dmitchellspace/bad-habips/README.md

# bad-habips
Repository for the High Altitude Balloon Instrumentation Platform senior design project for the 2017-2018 school year at the Rochester Institute of Technology
