dmitchellspace/bad-habips/PCB/Documentation/MainBoardV2_BOM.xlsx

Sheet: Rev 2
RIT MSD P18104: Bad Habips - High Altitute Balloon Instrumentation Platform Main Board V2 BOM
Ref | Description | Manf Part Number | Manf | Footprint | Purchase Link | Quantity | Price | Sub Total
C1, C2, C4, C5, C6, C7, C10, C11, C26 | 10uF, 25V | GRM21BR61E106MA73L | Murata | 0805(2012 Metric) | Digikey (https://www.digikey.com/product-detail/en/murata-electronics-north-america/GRM21BR61E106MA73L/490-10748-1-ND/5251352) | 9 | 0.21000 | 1.89
C3, C8, C15, C25 | 1uF, 16V | CL21B105KOFNNNG | Samsung | 0805(2012 Metric) | Digikey (https://www.digikey.com/product-detail/en/samsung-electro-mechanics/CL21B105KOFNNNG/1276-6471-1-ND/5958099) | 4 | 0.10000 | 0.40
C9, C24, C33 | 1nF | C0805C102K5RACTU | Kemet | 0805(2012 Metric) | Digikey (https://www.digikey.com/product-detail/en/kemet/C0805C102K5RACTU/399-1147-1-ND/411422) | 3 | 0.10000 | 0.30
C12, C18, C20, C22, C23, C27, C28, C29 | 0.1uF, 16V | ECP-U1C104MA5 | Panasonic | 0805(2012 Metric) | Digikey (https://www.digikey.com/product-detail/en/panasonic-electronic-components/ECP-U1C104MA5/PCF1126CT-ND/285453) | 8 | 0.66000 | 5.28
C13 | 10pF, 50V | CC0805JRNPO9BN100 | Yageo | 0805(2012 Metric) | Digikey (https://www.digikey.com/product-detail/en/yageo/CC0805JRNPO9BN100/311-1099-1-ND/303009) | 1 | 0.10000 | 0.10
C14 | 47uF, 16V | EMK325BJ476MM-P | Taiyo Yuden | 1210 (3225 Metric) | Digikey (https://www.digikey.com/product-detail/en/taiyo-yuden/EMK325BJ476MM-P/587-5436-1-ND/7067112) | 1 | 0.71000 | 0.71
C16 | 1F, 5.5V | KR-5R5C105-R | Eaton | Through-Hole | Digikey (https://www.digikey.com/product-detail/en/eaton/KR-5R5C105-R/283-2810-ND/1556238) | 1 | 2.72000 | 2.72
C17, C32 | 10000pF, 16V | ECH-U1C103JX5 | Panasonic | 0805(2012 Metric) | Digikey (https://www.digikey.com/product-detail/en/panasonic-electronic-components/ECH-U1C103JX5/PCF1196CT-ND/353743) | 2 | 0.46000 | 0.92
C30, C31 | 22pF | C0805C220J5GACTU | Kemet | 0805(2012 Metric) | Digikey (https://www.digikey.com/product-detail/en/kemet/C0805C220J5GACTU/399-1113-1-ND/411388) | 2 | 0.10000 | 0.20
D1, D2, D6 | 18V, 1W Zener | SMAZ18-13-F | Diodes Inc | DO-214AC | Digikey (https://www.digikey.com/product-detail/en/diodes-incorporated/SMAZ18-13-F/SMAZ18-FDICT-ND/816042) | 3 | 0.50000 | 1.50
D3, D4, D11 | 40V, 5A Schottky | CDBA540-HF | Comchip | DO-214AC | Digikey (https://www.digikey.com/product-detail/en/comchip-technology/CDBA540-HF/641-1707-1-ND/5226090) | 3 | 0.49000 | 1.47
D5 | Green LED | VLMG21J2M1-GS08 | Vishay | 2-SMD, J-Lead | Digikey (https://www.digikey.com/product-detail/en/vishay-semiconductor-opto-division/VLMG21J2M1-GS08/VLMG21J2M1-GS08CT-ND/4895911) | 1 | 0.47000 | 0.47
D7, D9 | Green LED | APT2012LZGCK | Kingbright | 0805(2012 Metric) | Digikey (https://www.digikey.com/product-detail/en/kingbright/APT2012LZGCK/754-1939-1-ND/5177469) | 2 | 0.61000 | 1.22
D8, D10 | Blue LED | HSMR-C170 | Broadcom | 0805(2012 Metric) | Digikey (https://www.digikey.com/product-detail/en/broadcom-limited/HSMR-C170/516-1445-1-ND/637769) | 2 | 0.89000 | 1.78
D16, D31, D34 | Red LED | LTST-C171KRKT | Lite-On | 0805(2012 Metric) | Digikey (https://www.digikey.com/product-detail/en/lite-on-inc/LTST-C171KRKT/160-1427-1-ND/386800) | 3 | 0.31000 | 0.93
D19, D20, D21, D22, D23, D24, D25, D26, D27, D28, D29, D30 | TVS Diodes | MMQA5V6T1G | On Semi | SC-74 | Digikey (https://www.digikey.com/product-detail/en/on-semiconductor/MMQA5V6T1G/MMQA5V6T1GOSCT-ND/1139867) | 12 | 0.31800 | 3.82
J1, J2, J3, J6, J7, J11, J12, J16 | 4POS 3MM Micro-Fit 3.0 Horizontal | 0430450400 | Molex | Custom Through-Hole | Digikey (https://www.digikey.com/product-detail/en/molex-llc/0430450400/WM1814-ND/252527) | 8 | 1.35000 | 10.80
Mates for Above | 4POS 3MM Mating Micro-Fit 3.0 | 43025-0400 | Molex | In-Line | Digikey (https://www.digikey.com/product-detail/en/molex-llc/43025-0400/WM1784-ND/252497) | 8 | 0.40000 | 3.20
J4, J9 | 6POS 3MM Micro-Fit 3.0 Horizontal | 0430450600 | Molex | Custom Through-Hole | Digikey (https://www.digikey.com/product-detail/en/molex-llc/0430450600/WM1815-ND/252528) | 2 | 1.71000 | 3.42
Mates for Above | 6POS 3MM Mating Micro-Fit 3.0 | 43025-0600 | Molex | In-Line | Digikey (https://www.digikey.com/product-detail/en/molex-llc/43025-0600/WM1785-ND/252498) | 2 | 0.43000 | 0.86
J5 | 8POS 3MM Micro-Fit 3.0 Horizontal | 0430450800 | Molex | Custom Through-Hole | Digikey (https://www.digikey.com/product-detail/en/molex-llc/0430450800/WM1816-ND/252529) | 1 | 2.09000 | 2.09
Mates for Above | 8POS 3MM Mating Micro-Fit 3.0 | 43025-0800 | Molex | In-Line | Digikey (https://www.digikey.com/product-detail/en/molex-llc/43025-0800/WM1786-ND/252499) | 1 | 0.49000 | 0.49
J8, J10, J14, J15, J17 | 2POS Right Angle Vertical | 1586041-2 | TE Connect. | Custom Through-Hole | Digikey (https://www.digikey.com/product-detail/en/1586041-2/A30614-ND/701619) | 5 | 0.70000 | 3.50
Mates for Above | CONN RCPT HOUSING 2POS 4.2MM | 1586019-2 | TE Connect. | In-Line | Digikey (https://www.digikey.com/product-detail/en/te-connectivity-amp-connectors/1586019-2/A107333-ND/1131454) | 5 | 0.21000 | 1.05
J13 | 4POS JST-PH Vertical 2.54mm | 4330589508 | WGCD | 2.54MM Header | Amazon (https://smile.amazon.com/gp/product/B071XW2JND/ref=oh_aui_detailpage_o05_s00?ie=UTF8&psc=1) | 1 | 9.79000 | 9.79
J18 | 7POS JST-PH Vertical 2.54mm | 4330589508 | WGCD | 2.54MM Header
Mates for Above | Kit included mates and pins | 4330589508 | WGCD | In-Line
J21 | 2POS 3MM Micro-Fit 3.0 Horizontal | 0436500200 | Molex | Custom Through-Hole | Digikey (https://www.digikey.com/product-detail/en/molex-llc/0436500200/WM1860-ND/268989) | 1 | 0.91000 | 0.91
Mates for Above | 2POS 3MM Mating Micro-Fit 3.0 | 43645-0200 | Molex | In-Line | Digikey (https://www.digikey.com/product-detail/en/molex-llc/43645-0200/WM1845-ND/268974) | 1 | 0.31000 | 0.31
TE Pins | Mating Pins for TE Connector | 1586315-1 | TE Connect. | In-Line | Digikey (https://www.digikey.com/product-detail/en/te-connectivity-amp-connectors/1586315-1/A30642-ND/701647) | 50 | 0.04520 | 2.26
Molex Pins | Mating pins for Molex Connectors | 43030-0001 | Molex | In-Line | Digikey (https://www.digikey.com/product-detail/en/molex-llc/43030-0001/WM1837CT-ND/467810) | 100 | 0.08390 | 8.39
J19 | Headers - 1x2 | B01MQ48T2V | OCRTech | 2.54MM Header | Amazon (https://smile.amazon.com/OCR-Breakaway-Connector-Assortment-Arduino/dp/B01MQ48T2V) | 1 | 6.99000 | 6.99
 |  |  |  |  |  | 0 |  | 0.00
L1 | 6.8uH, 3.7A | NRS8040T6R8NJGJ | Taiyo Yuden | Nonstandard SMT | Digikey (https://www.digikey.com/product-detail/en/taiyo-yuden/NRS8040T6R8NJGJ/587-2979-1-ND/2666084) | 1 | 0.51000 | 0.51
 |  |  |  |  |  | 0 |  | 0.00
Q1 | N-CH, 30V, 20A | NTD20N03L27T4G | On Semi | DPAK | Digikey (https://www.digikey.com/product-detail/en/on-semiconductor/NTD20N03L27T4G/NTD20N03L27T4GOSCT-ND/921548) | 1 | 1.08000 | 1.08
Q2, Q4, Q17 | P-CH, 30V, 3.8A | DMP3099L-7 | Diodes Inc. | SOT-23-3 | Digikey (https://www.digikey.com/product-detail/en/diodes-incorporated/DMP3099L-7/DMP3099L-7DICT-ND/5218217) | 3 | 0.42 | 1.26
Q3, Q5, Q6, Q7, Q8, Q9, Q12, Q14, Q15, Q18 | N-CH, 30V, 500mA | NTR4003NT3G | ON Semi | SOT-23-3 | Digikey (https://www.digikey.com/product-detail/en/on-semiconductor/NTR4003NT3G/NTR4003NT3GOSCT-ND/1967271) | 10 | 0.29 | 2.92
 |  |  |  |  |  | 0 |  | 0.00
R1, R4, R6, R37, R38, R40, R41, R43, R44, R45, R46, R51, R52, R53, R61, R63, R64 | 10kΩ,, 0.4W | ESR10EZPJ103 | Rohm | 0805 (2012 Metric) | Digikey (https://www.digikey.com/product-detail/en/rohm-semiconductor/ESR10EZPJ103/RHM10KKCT-ND/1762952) | 17 | 0.09 | 1.48
R2 | 2Ω, 1%, 20W | PF1262-2RF1 | Riedon | TO126 | Digikey (https://www.digikey.com/scripts/DkSearch/dksus.dll?Detail&itemSeq=251921007&uq=636546449291790512) | 1 | 3.04000 | 3.04
R3, R35, R47, R48, R49, R59 | 10Ω, 5%, 2/5W | ESR10EZPJ100 | Rohm | 0805 (2012 Metric) | Digikey (https://www.digikey.com/product-detail/en/rohm-semiconductor/ESR10EZPJ100/RHM10KCT-ND/1762949) | 6 | 0.10 | 0.60
R5, R8, R9 | 10mΩ, 1%, 1W | WSLP0805R0100FEA18 | Vishay Dale | 0805 (2012 Metric) | Digikey (https://www.digikey.com/products/en/resistors/chip-resistor-surface-mount/52?k=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) | 3 | 1.08000 | 3.24
R7 | 100kΩ, 5%, 1/8W | RC0805JR-07100KL | Yageo | 0805 (2012 Metric) | Digikey (https://www.digikey.com/product-detail/en/yageo/RC0805JR-07100KL/311-100KARCT-ND/731186) | 1 | 0.10000 | 0.10
R10 | 40.2kΩ, 1%, 1/8W | RC0805FR-0740K2L | Yageo | 0805 (2012 Metric) | Digikey (https://www.digikey.com/product-detail/en/yageo/RC0805FR-0740K2L/311-40.2KCRCT-ND/730888) | 1 | 0.10000 | 0.10
R11 | 3.57kΩ, 1%, 1/8W | RC0805FR-073K57L | Yageo | 0805 (2012 Metric) | Digikey (https://www.digikey.com/product-detail/en/yageo/RC0805FR-073K57L/311-3.57KCRCT-ND/730772) | 1 | 0.10000 | 0.10
R12 | 10.5kΩ, 1%, 1/8W | RC0805FR-0710K5L | Yageo | 0805 (2012 Metric) | Digikey (https://www.digikey.com/product-detail/en/yageo/RC0805FR-0710K5L/311-10.5KCRCT-ND/730487) | 1 | 0.10000 | 0.10
R13 | 7.5kΩ, 1%, 1/8W | RC0805FR-077K5L | Yageo | 0805 (2012 Metric) | Digikey (https://www.digikey.com/product-detail/en/yageo/RC0805FR-077K5L/311-7.50KCRCT-ND/731063) | 1 | 0.10000 | 0.10
R14 | 11.8kΩ, 1%, 1/8W | RC0805FR-0711K8L | Yageo | 0805 (2012 Metric) | Digikey (https://www.digikey.com/product-detail/en/yageo/RC0805FR-0711K8L/311-11.8KCRCT-ND/730505) | 1 | 0.10000 | 0.10
R15 | 261kΩ, 1%, 1/8W | RC0805FR-07261KL | Yageo | 0805 (2012 Metric) | Digikey (https://www.digikey.com/product-detail/en/yageo/RC0805FR-07261KL/311-261KCRCT-ND/730723) | 1 | 0.10000 | 0.10
R16 | 35.7kΩ, 1%, 1/8W | RC0805FR-0735K7L | Yageo | 0805 (2012 Metric) | Digikey (https://www.digikey.com/product-detail/en/yageo/RC0805FR-0735K7L/311-35.7KCRCT-ND/730826) | 1 | 0.10000 | 0.10
R17 | 681kΩ, 1%, 1/8W | RC0805FR-07681KL | Yageo | 0805 (2012 Metric) | Digikey (https://www.digikey.com/product-detail/en/yageo/RC0805FR-07681KL/311-681KCRCT-ND/731051) | 1 | 0.10000 | 0.10
R18, R21, R24 | 102kΩ, 1%, 1/8W | RC0805FR-07102KL | Yageo | 0805 (2012 Metric) | Digikey (https://www.digikey.com/product-detail/en/yageo/RC0805FR-07102KL/311-102KCRCT-ND/730493) | 3 | 0.10000 | 0.30
R19 | 107kΩ, 1%, 1/8W | RC0805FR-07107KL | Yageo | 0805 (2012 Metric) | Digikey (https://www.digikey.com/product-detail/en/yageo/RC0805FR-07107KL/311-107KCRCT-ND/730497) | 1 | 0.10000 | 0.10
R20, R23 | 41.2kΩ, 1%, 1/8W | RC0805FR-0741K2L | Yageo | 0805 (2012 Metric) | Digikey (https://www.digikey.com/product-detail/en/yageo/RC0805FR-0741K2L/311-41.2KCRCT-ND/730892) | 2 | 0.10000 | 0.20
R22, R25, R29, R32 | 10.2kΩ, 1%, 1/8W | RC0805FR-0710K2L | Yageo | 0805 (2012 Metric) | Digikey (https://www.digikey.com/product-detail/en/yageo/RC0805FR-0710K2L/311-10.2KCRCT-ND/730485) | 4 | 0.10000 | 0.40
R26 | 75kΩ, 1%, 1/8W | RC0805FR-0775KL | Yageo | 0805 (2012 Metric) | Digikey (https://www.digikey.com/product-detail/en/yageo/RC0805FR-0775KL/311-75.0KCRCT-ND/731080) | 1 | 0.10000 | 0.10
R27 | 13.7kΩ, 1%, 1/8W | RC0805FR-0713K7L | Yageo | 0805 (2012 Metric) | Digikey (https://www.digikey.com/product-detail/en/yageo/RC0805FR-0713K7L/311-13.7KCRCT-ND/730535) | 1 | 0.10000 | 0.10
R28 | 18.7kΩ, 1%, 1/8W | RC0805FR-0718K7L | Yageo | 0805 (2012 Metric) | Digikey (https://www.digikey.com/product-detail/en/yageo/RC0805FR-0718K7L/311-18.7KCRCT-ND/730595) | 1 | 0.10000 | 0.10
R30, R33 | 43.2kΩ, 1%, 1/8W | RC0805FR-0743K2L | Yageo | 0805 (2012 Metric) | Digikey (https://www.digikey.com/product-detail/en/yageo/RC0805FR-0743K2L/311-43.2KCRCT-ND/730902) | 2 | 0.10000 | 0.20
R31, R34 | 15kΩ, 1%, 1/8W | RC0805FR-0715KL | Yageo | 0805 (2012 Metric) | Digikey (https://www.digikey.com/product-detail/en/yageo/RC0805FR-0715KL/311-15.0KCRCT-ND/730555) | 2 | 0.10000 | 0.20
R36, R54 | 1.2kΩ, 5%, 1/8W | RC0805FR-071K2L | Yageo | 0805 (2012 Metric) | Digikey (https://www.digikey.com/product-detail/en/yageo/RC0805FR-071K2L/311-1.20KCRCT-ND/730413) | 2 | 0.10000 | 0.20
R39, R55 | 100Ω, 5%, 1/8W | RC0805JR-07100RL | Yageo | 0805 (2012 Metric) | Digikey (https://www.digikey.com/product-detail/en/yageo/RC0805JR-07100RL/311-100ARCT-ND/731185) | 2 | 0.10000 | 0.20
R42, R57 | 150Ω, 5%, 1/8W | RC0805JR-07150RL | Yageo | 0805 (2012 Metric) | Digikey (https://www.digikey.com/product-detail/en/yageo/RC0805JR-07150RL/311-150ARCT-ND/731202) | 2 | 0.10000 | 0.20
R50 | 0, 1/8W | RC0805JR-070RL | Yageo | 0805 (2012 Metric) | Digikey (https://www.digikey.com/product-detail/en/yageo/RC0805JR-070RL/311-0.0ARCT-ND/731163) | 1 | 0.10000 | 0.10
R60 | 330Ω, 5%, 1/8W | RC0805JR-07330RL | Yageo | 0805 (2012 Metric) | Digikey (https://www.digikey.com/product-detail/en/yageo/RC0805JR-07330RL/311-330ARCT-ND/731258) | 1 | 0.10000 | 0.10
R62 | 910Ω, 5%, 1/8W | RC0805JR-07910RL | Yageo | 0805 (2012 Metric) | Digikey (https://www.digikey.com/product-detail/en/yageo/RC0805JR-07910RL/311-910ARCT-ND/731329) | 1 | 0.10000 | 0.10
 |  |  |  |  |  | 0 |  | 0.00
SW1, SW3 | TACTILE SPST-NO 0.05A 12V | PTS645SM43SMTR92 LFS | C & K | Nonstandard SMT | Digikey (https://www.digikey.com/product-detail/en/c-k/PTS645SM43SMTR92%20LFS/CKN9112CT-ND/1146934) | 2 | 0.16000 | 0.32
SW2, SW4 | SWITCH SLIDE DPDT 5A 120V | 500SDP1S1M2QEA | E-Switch | Throuh Hole | Digikey (https://www.digikey.com/scripts/DkSearch/dksus.dll?Detail&itemSeq=251921006&uq=636546479865490512) | 2 | 3.55000 | 7.10
 |  |  |  |  |  | 0 |  | 0.00
U1 | Dual Power Monitor | LTC2992IDE#PBF | Linear Tech | 16-DFN (4x3) | Digikey (https://www.digikey.com/product-detail/en/linear-technology-analog-devices/LTC2992IDE-PBF/LTC2992IDE-PBF-ND/7807747) | 1 | 9.64000 | 9.64
U2, U3 | Adjustable 1.5A LDO | AZ2117H-ADJTRG1 | Diodes Inc. | SOT-223 | Digikey (https://www.digikey.com/product-detail/en/AZ2117H-ADJTRG1/AZ2117H-ADJTRG1DICT-ND/7670077) | 2 | 0.40000 | 0.80
U4 | Switching Regulator | LT8609EMSE#PBF | Linear Tech | 10-TFSOP, 10-MSOP | Digikey (https://www.digikey.com/products/en?keywords=LT8609EMSE%23PBF) | 1 | 5.46 | 5.46
U5 | Teensy 3.6 | TEENSY36 | PJRC | DIP | PJRC (https://www.pjrc.com/store/teensy36.html) | 1 | 29.95000 | 29.95
U6 | IMU + Magnetometer | LSM9DS1TR | ST Micro | Nonstandard SMT | Digikey (https://www.digikey.com/product-detail/en/stmicroelectronics/LSM9DS1TR/497-14946-1-ND/4988079) | 1 | 6.33000 | 6.33
U7 | Temp/Pressure/Humidity Sensor | BME280 | Bosch | 8-LGA | Digikey (https://www.digikey.com/product-detail/en/bosch-sensortec/BME280/828-1063-1-ND/6136314) | 1 | 7.56 | 7.56
U8 | MCU 16BIT 256KB FRAM | MSP430FR5994IPNR | T.I. | 80LQFP | Digikey (https://www.digikey.com/product-detail/en/texas-instruments/MSP430FR5994IPNR/296-45561-1-ND/6826916) | 1 | 7.89000 | 7.89
U10, U11, U12 | TVS DIODE 2.5VWM 5VC | AOZ8318DI | A & O Semi | 10DFN | Digikey (https://www.digikey.com/product-detail/en/alpha-omega-semiconductor-inc/AOZ8318DI/785-1703-1-ND/5014273) | 3 | 0.91000 | 2.73
 |  |  |  |  |  | 0 |  | 0.00
Y1 | 32.7680kHZ Crystal | AB38T-32.768KHZ | Abracon | Through Hole | Digikey (https://www.digikey.com/product-detail/en/abracon-llc/AB38T-32.768KHZ/535-9034-ND/675229) | 1 | 0.17 | 0.17
Y2 | 24.000MHZ CMOS | ASEMB-24.000MHZ-LC-T | Abracon | 4-SMD | Digikey (https://www.digikey.com/product-detail/en/abracon-llc/ASEMB-24.000MHZ-LC-T/535-11748-1-ND/2809997) | 1 | 1.14000 | 1.14
 |  |  |  |  |  | 0 |  | 0.00
 |  |  |  |  |  | Total Cost |  | 174.48

Sheet: Reference
RIT MSD P18104: Bad Habips - High Altitute Balloon Instrumentation Platform Main Board V2 BOM
Ref | Description | Manf Part Number | Manf | Footprint | Datasheet | Purchase Link | Quantity | Price | Sub Total
C1, C2 | 8pF, 50V | CL21C080CBANNNC | Samsung | 0805(2012 Metric) |  | Digikey (https://www.digikey.com/product-detail/en/samsung-electro-mechanics-america-inc/CL21C080CBANNNC/1276-2556-1-ND/3890642) | 2 | 0.10 | 0.20
C3, C6, C12, C18, C19, C22, C23 | 0.1uF, 16V | ECP-U1C104MA5 | Panasonic | 0805(2012 Metric) |  | Digikey (https://www.digikey.com/product-detail/en/panasonic-electronic-components/ECP-U1C104MA5/PCF1126CT-ND/285453) | 7 | 0.66 | 4.62
C4 | 1F, 5.5V | KR-5R5C105-R | Eaton | Through-Hole |  | Digikey (https://www.digikey.com/product-detail/en/eaton/KR-5R5C105-R/283-2810-ND/1556238) | 1 | 2.72 | 2.72
C5, C7, C10 | 10uF, 25V | GRM21BR61E106MA73L | Murata | 0805(2012 Metric) |  | Digikey (https://www.digikey.com/product-detail/en/murata-electronics-north-america/GRM21BR61E106MA73L/490-10748-1-ND/5251352) | 3 | 0.21 | 0.63
C8, C13 | 1uF, 16V | CL21B105KOFNNNG | Samsung | 0805(2012 Metric) |  | Digikey (https://www.digikey.com/product-detail/en/samsung-electro-mechanics/CL21B105KOFNNNG/1276-6471-1-ND/5958099) | 2 | 0.10 | 0.20
C9 | 10nF, 50V | CC0805KRX7R9BB103 | Yageo | 0805(2012 Metric) |  | Digikey (https://www.digikey.com/product-detail/en/yageo/CC0805KRX7R9BB103/311-1136-1-ND/303046) | 1 | 0.10 | 0.10
C11 | 10000pF, 16V | ECH-U1C103JX5 | Panasonic | 0805(2012 Metric) |  | Digikey (https://www.digikey.com/product-detail/en/panasonic-electronic-components/ECH-U1C103JX5/PCF1196CT-ND/353743) | 1 | 0.46 | 0.46
C14 | 10pF, 50V | CC0805JRNPO9BN100 | Yageo | 0805(2012 Metric) |  | Digikey (https://www.digikey.com/product-detail/en/yageo/CC0805JRNPO9BN100/311-1099-1-ND/303009) | 1 | 0.10 | 0.10
C15, C21 | 47uF, 25V | TMK325ABJ476MM-P | Taiyo Yuden | 1210 (3225 Metric) |  | Digikey (https://www.digikey.com/product-detail/en/taiyo-yuden/TMK325ABJ476MM-P/587-5479-1-ND/7067155) | 2 | 1.24 | 2.48
C16 | 0.1uF, 100V | CL21B104KCFNNNE | Samsung | 0805(2012 Metric) |  | Digikey (https://www.digikey.com/product-detail/en/samsung-electro-mechanics/CL21B104KCFNNNE/1276-6840-1-ND/5961699) | 1 | 0.10 | 0.10
C17 | 47nF, 50V | CL21B473KBCWPNC | Samsung | 0805(2012 Metric) |  | Digikey (https://www.digikey.com/product-detail/en/samsung-electro-mechanics/CL21B473KBCWPNC/1276-6567-1-ND/5961426) | 1 | 0.10 | 0.10
C20 | 6.8uF, 10V | C2012X7R1A685K125AC | TDK | 0805(2012 Metric) |  | Digikey (https://www.digikey.com/product-detail/en/tdk-corporation/C2012X7R1A685K125AC/445-14529-1-ND/3956195) | 1 | 0.46 | 0.46
D1, D5, D10 | 15V TVS | MMBZ15VALT1 | On Semi | SOT-23-3 (TO-236) |  | Digikey (https://www.digikey.com/product-detail/en/on-semiconductor/MMBZ15VALT1G/MMBZ15VALT1GOSCT-ND/964552) | 3 | 0.23 | 0.69
D2 | 33V TVS | MMBZ33VALT1G | On Semi | SOT-23-3 (TO-236) |  | Digikey (https://www.digikey.com/product-detail/en/on-semiconductor/MMBZ33VALT1G/MMBZ33VALT1GOSCT-ND/1139843) | 1 | 0.21 | 0.21
D3 | Gen Purp, 200mA | BAS21LT1G | On Semi | SOT-23-3 (TO-236) |  | Digikey (https://www.digikey.com/product-detail/en/on-semiconductor/BAS21LT1G/BAS21LT1GOSCT-ND/917803) | 1 | 0.11 | 0.11
D4 | Green | VLMG21J2M1-GS08 | Vishay | 2-SMD, J-Lead |  | Digikey (https://www.digikey.com/product-detail/en/vishay-semiconductor-opto-division/VLMG21J2M1-GS08/VLMG21J2M1-GS08CT-ND/4895911) | 1 | 0.47 | 0.47
D6 | Orange | VLMO20J2M1-GS08 | Vishay | 2-SMD, J-Lead |  | Digikey (https://www.digikey.com/product-detail/en/vishay-semiconductor-opto-division/VLMO20J2M1-GS08/VLMO20J2M1-GS08CT-ND/4895914) | 1 | 0.43 | 0.43
D7, D15, D16 | Sschottky 40V 2A | CDBA240LL-HF | Comchip | DO-214AC, SMA |  | Digikey (https://www.digikey.com/product-detail/en/comchip-technology/CDBA240LL-HF/641-1698-1-ND/5226081) | 3 | 0.55 | 1.65
D8, D11, D13, D14, D21 | 5.1V, 500mW Zener | MMSZ5231B-7-F | Diodes Inc. | SOD-123 |  | Digikey (https://www.digikey.com/product-detail/en/diodes-incorporated/MMSZ5231B-7-F/MMSZ5231B-FDICT-ND/755506) | 5 | 0.16 | 0.80
D9 | Amber | VLMK233U1AA-GS08 | Vishay | 2-SMD, J-Lead |  | Digikey (https://www.digikey.com/product-detail/en/vishay-semiconductor-opto-division/VLMK233U1AA-GS08/VLMK233U1AA-GS08CT-ND/3025480) | 1 | 0.55 | 0.55
D12 | Blue | CLM3A-BKW-CTBVA463 | Cree | 2-SMD, J-Lead |  | Digikey (https://www.digikey.com/product-detail/en/cree-inc/CLM3A-BKW-CTBVA463/CLM3A-BKW-CTBVA463CT-ND/6561769) | 1 | 0.16 | 0.16
D17, D18 | 25V TVS Zener | PGB1010603MR | Littlefuse | 0603 (1608 Metric) |  | Digikey (https://www.digikey.com/product-detail/en/littelfuse-inc/PGB1010603MR/F2594CT-ND/813072) | 2 | 0.65 | 1.30
D19 | 93.6V TVS Zener, 400W Peak | SMAJ58CA | Littlefuse | DO-214AC |  | Digikey (https://www.digikey.com/product-detail/en/littelfuse-inc/SMAJ58CA/SMAJ58CALFCT-ND/762523) | 1 | 0.45 | 0.45
D20 | 17.8V TVS Zener, 1500W Peak | SMCJ16A | Littlefuse | DO-214AB |  | Digikey (https://www.digikey.com/product-detail/en/littelfuse-inc/SMCJ16A/SMCJ16ALFCT-ND/762596) | 1 | 0.64 | 0.64
F1 | 10A, 5x20mm | 0034.1526 | Shuter Inc. | Fuse Holder |  | Digikey (https://www.digikey.com/product-detail/en/schurter-inc/0031.8201/486-1258-ND/669925) | 1 | 0.63 | 0.63
J1 | 3-Port Terminal Block (Female) | 282836-3 | TE Connectivity | Custom Through-Hole |  | Digikey (https://www.digikey.com/product-detail/en/te-connectivity-amp-connectors/282836-3/A98077-ND/1826940) | 1 | 0.79 | 0.79
J2 | 6POS 3MM Micro-Fit 3.0 Horizontal | 0430450600 | Molex | Custom Through-Hole |  | Digikey (https://www.digikey.com/product-detail/en/molex-llc/0430450600/WM1815-ND/252528) | 1 | 1.71 | 1.71
J3, J4, J8 | 2POS 3MM Micro-Fit 3.0 Vertical | 0436500215 | Molex | Custom Through-Hole |  | Digikey (https://www.digikey.com/product-detail/en/molex-llc/0436500215/WM1917-ND/283461) | 3 | 0.76 | 2.28
J5 | 4POS 3MM Micro-Fit 3.0 Horizontal | 0430450400 | Molex | Custom Through-Hole |  | Digikey (https://www.digikey.com/product-detail/en/molex-llc/0430450400/WM1814-ND/252527) | 1 | 1.35 | 1.35
J7 | Arduino_Mega_Header | N/A | N/A | N/A |  | N/A | 1 | 0.00 | 0.00
J9 | 4POS 3MM Micro-Fit 3.0 Vertical | 0430450427 | Molex | Custom Through-Hole |  | Digikey (https://www.digikey.com/product-detail/en/molex-llc/0430450427/WM10667-ND/3310189) | 1 | 1.28 | 1.28
K1 | 10A Relay | G5LE-1A4DC9 | Omron | Through-Hole |  | Digikey (https://www.digikey.com/product-detail/en/omron-electronics-inc-emc-div/G5LE-1A4DC9/Z3117-ND/1815643) | 1 | 1.41 | 1.41
L1 | 10uH | NR10050T100M | Taiyo Yuden | Custom SMT |  | Digikey (https://www.digikey.com/product-detail/en/taiyo-yuden/NR10050T100M/587-1698-1-ND/1008012) | 1 | 0.78 | 0.78
Q1, Q2, Q5, Q7, Q10, Q11, Q12 | N-CH, 30V, 500mA | NTR4003NT3G | ON Semi | SOT-23-3 (TO-236) |  | Digikey (https://www.digikey.com/product-detail/en/on-semiconductor/NTR4003NT3G/NTR4003NT3GOSCT-ND/1967271) | 7 | 0.31 | 2.17
Q3, Q4, Q6, Q8, Q9 | P-CH, 30V, 3.8A | DMP3099L-7 | Diodes Inc. | SOT-23 |  | Digikey (https://www.digikey.com/product-detail/en/diodes-incorporated/DMP3099L-7/DMP3099L-7DICT-ND/5218217) | 5 | 0.42 | 2.10
Q13 | P-CH 60V 8.6A | SI7461DP-T1-E3 | Vishay | PowerPAK® SO-8 |  | Digikey (https://www.digikey.com/product-detail/en/vishay-siliconix/SI7461DP-T1-E3/SI7461DP-T1-E3CT-ND/1657125) | 1 | 2.02 | 2.02
Q14 | N-CH 80V 30A | IRLR2908TRLPBF | Infineon | TO-252-3, Dpak |  | Digikey (https://www.digikey.com/product-detail/en/infineon-technologies/IRLR2908TRLPBF/IRLR2908TRLPBFCT-ND/1925558) | 1 | 1.28 | 1.28
R1 | 360, 0.4W | ESR10EZPJ361 | Rohm | 0805 (2012 Metric) |  | Digikey (https://www.digikey.com/product-detail/en/rohm-semiconductor/ESR10EZPJ361/RHM360KCT-ND/1763016) | 1 | 0.10 | 0.10
R2, R3, R6, R7, R10, R12, R13, R15, R16, R17, R18, R22, R23, R27, R28, R31, R32, R34, R39, R40, R45 | 10k, 0.4W | ESR10EZPJ103 | Rohm | 0805 (2012 Metric) |  | Digikey (https://www.digikey.com/product-detail/en/rohm-semiconductor/ESR10EZPJ103/RHM10KKCT-ND/1762952) | 21 | 0.10 | 2.10
R4 | 270, 2/5W | ESR10EZPJ271 | Rohm | 0805 (2012 Metric) |  | Digikey (https://www.digikey.com/product-detail/en/rohm-semiconductor/ESR10EZPJ271/RHM270KCT-ND/1762999) | 1 | 0.10 | 0.10
R5, R20 | 7.5k, 2/5W | ESR10EZPJ752 | Rohm | 0805 (2012 Metric) |  | Digikey (https://www.digikey.com/product-detail/en/rohm-semiconductor/ESR10EZPJ752/RHM7.5KKCT-ND/1763052) | 2 | 0.10 | 0.20
R8 | 0, 1/8W | RC0805JR-070RL | Yageo | 0805 (2012 Metric) |  | Digikey (https://www.digikey.com/product-detail/en/yageo/RC0805JR-070RL/311-0.0ARCT-ND/731163) | 1 | 0.10 | 0.10
R9, R24, R26, R35, R36, R41, R46 | 10, 2/5W | ESR10EZPJ100 | Rohm | 0805 (2012 Metric) |  | Digikey (https://www.digikey.com/product-detail/en/rohm-semiconductor/ESR10EZPJ100/RHM10KCT-ND/1762949) | 7 | 0.10 | 0.70
R11 | 1.6k, 2/5W | ESR10EZPJ162 | Rohm | 0805 (2012 Metric) |  | Digikey (https://www.digikey.com/product-detail/en/rohm-semiconductor/ESR10EZPJ162/RHM1.6KKCT-ND/1762973) | 1 | 0.10 | 0.10
R14 | 1.1k, 2/3 W | ERJ-P08J112V | Panasonic | 1206 (3216 Metric) |  | Digikey (https://www.digikey.com/product-detail/en/panasonic-electronic-components/ERJ-P08J112V/P1.1KALCT-ND/525563) | 1 | 0.16 | 0.16
R19 | 300, 2/5W | ESR10EZPJ301 | Rohm | 0805 (2012 Metric) |  | Digikey (https://www.digikey.com/product-detail/en/rohm-semiconductor/ESR10EZPJ301/RHM300KCT-ND/1763007) | 1 | 0.10 | 0.10
R21 | 1.1k, 2/5W | ESR10EZPJ112 | Rohm | 0805 (2012 Metric) |  | Digikey (https://www.digikey.com/product-detail/en/rohm-semiconductor/ESR10EZPJ112/RHM1.1KKCT-ND/1762957) | 1 | 0.10 | 0.10
R25 | 40.2k, 1/4W, 1% | RNCP0805FTD40K2 | Stackpole | 0805 (2012 Metric) |  | Digikey (https://www.digikey.com/product-detail/en/stackpole-electronics-inc/RNCP0805FTD40K2/RNCP0805FTD40K2CT-ND/2240622) | 1 | 0.10 | 0.10
R29 | 124k, 1/8W, 1% | ERJ-6ENF1243V | Panasonic | 0805 (2012 Metric) |  | Digikey (https://www.digikey.com/product-detail/en/panasonic-electronic-components/ERJ-6ENF1243V/P124KCCT-ND/119578) | 1 | 0.10 | 0.10
R30 | 11.8k, 1/8W, 1% | ERJ-6ENF1182V | Panasonic | 0805 (2012 Metric) |  | Digikey (https://www.digikey.com/product-detail/en/panasonic-electronic-components/ERJ-6ENF1182V/P11.8KCCT-ND/119282) | 1 | 0.10 | 0.10
R33 | 1k, 1/2W, 5% | ERJ-P06J102V | Panasonic | 0805 (2012 Metric) |  | Digikey (https://www.digikey.com/product-detail/en/panasonic-electronic-components/ERJ-P06J102V/P1.0KADCT-ND/525437) | 1 | 0.12 | 0.12
R37 | 147k, 1/8W, 1% | ERJ-6ENF1473V | Panasonic | 0805 (2012 Metric) |  | Digikey (https://www.digikey.com/product-detail/en/panasonic-electronic-components/ERJ-6ENF1473V/P147KCCT-ND/119599) | 1 | 0.10 | 0.10
R38 | 30.1k, 1/8W, 1% | ERJ-6ENF3012V | Panasonic | 0805 (2012 Metric) |  | Digikey (https://www.digikey.com/product-detail/en/panasonic-electronic-components/ERJ-6ENF3012V/P30.1KCCT-ND/119400) | 1 | 0.10 | 0.10
R42 | 10m, 1/2W, 5% | ERJ-6CWJR010V | Panasonic | 0805 (2012 Metric) |  | Digikey (https://www.digikey.com/product-detail/en/panasonic-electronic-components/ERJ-6CWJR010V/P19208CT-ND/6004563) | 1 | 0.50 | 0.50
R43 | 57.6k, 1/8W, 1% | ERJ-6ENF5762V | Panasonic | 0805 (2012 Metric) |  | Digikey (https://www.digikey.com/product-detail/en/panasonic-electronic-components/ERJ-6ENF5762V/P57.6KCCT-ND/119481) | 1 | 0.10 | 0.10
R44 | 4.99k, 1/8W, 1% | ERJ-6ENF4991V | Panasonic | 0805 (2012 Metric) |  | Digikey (https://www.digikey.com/product-detail/en/panasonic-electronic-components/ERJ-6ENF4991V/P4.99KCCT-ND/119161) | 1 | 0.10 | 0.10
S1 | SW_SPDT | SS-12D07-VG 4 NS GA PA | C&K | Custom Through Hole |  | Digikey (https://www.digikey.com/product-detail/en/c-k/SS-12D07-VG-4-NS-GA-PA/CKN10397-ND/2747177) | 1 | 0.45 | 0.45
T1 | 9V Main
T2 | 9V Battery
T3 | Vehicle Power
T4 | Protected Power
T5 | Switch Feedback
T6 | Fault Timer
T7 | Surge Feedback
T8 | Surge Gate
T9 | UV Divider
T10 | OV Divider
T11 | I2C Data
T12 | I2C Clock
T13 | Switch
T14 | GND
U1 | PCF2123TS | PCF2123TS/1,118 | NXP | 14-TSSOP |  | Digikey (https://www.digikey.com/product-detail/en/nxp-usa-inc/PCF2123TS-1,118/568-4534-1-ND/1963421) | 1 | 1.22 | 1.22
U2 | Temp/Pressure/Humidity | BME280 | Bosch | Custom |  | Digikey (https://www.digikey.com/product-detail/en/bosch-sensortec/BME280/828-1063-1-ND/6136314) | 1 | 7.56 | 7.56
U3 | Switching Regulator | LT8609EMSE#TRPBF | Linear Tech | 10-TFSOP, 10-MSOP |  | Digikey (https://www.digikey.com/product-detail/en/linear-technology/LT8609EMSE-TRPBF/LT8609EMSE-TRPBFCT-ND/7838162) | 1 | 6.26 | 6.26
U4 | Surge Suppression, Input Protection | LT4363HMS-2#TRPBF | Linear Tech | 12-TSSOP |  | Digikey (https://www.digikey.com/products/en/circuit-protection/surge-suppression-ics/152?k=LT4363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) | 1 | 7.81 | 7.81
U5 | RS232 Transceiver | SP3232EEY-L/TR | Exar | 16-TSSOP |  | Digikey (https://www.digikey.com/product-detail/en/exar-corporation/SP3232EEY-L-TR/1016-1808-1-ND/3586525) | 1 | 1.37 | 1.37
Y1 | 32.7680kHZ Crystal | AB38T-32.768KHZ | Abracon | Through Hole |  | Digikey (https://www.digikey.com/product-detail/en/abracon-llc/AB38T-32.768KHZ/535-9034-ND/675229) | 1 | 0.17 | 0.17
Internal Interface Components (Not Part of Board)
 | 2-Pin Molex (Female) | 43645-0200 | Molex | Connector | 2-Pin Molex Female | Digikey (https://www.digikey.com/product-detail/en/molex-llc/43645-0200/WM1845-ND/268974) | 4 | 0.31 | 1.24
 | 2-Pin Molex (Female) | 43645-0200 | Molex | Connector | 2-Pin Molex Female | Digikey (https://www.digikey.com/product-detail/en/molex-llc/43645-0200/WM1845-ND/268974) | Duplicate
 | 2-Pin Molex (Female) | 43645-0200 | Molex | Connector | 2-Pin Molex Female | Digikey (https://www.digikey.com/product-detail/en/molex-llc/43645-0200/WM1845-ND/268974) | Duplicate
 | 2-Pin Molex (Female) | 43645-0200 | Molex | Connector | 2-Pin Molex Female | Digikey (https://www.digikey.com/product-detail/en/molex-llc/43645-0200/WM1845-ND/268974) | Duplicate
 | 6-Pin Molex (Female) | 43025-0600 | Molex | Connector | 6-Pin Molex Female | Digikey (https://www.digikey.com/product-detail/en/molex-llc/43025-0600/WM1785-ND/252498) | 1 | 0.43 | 0.43
 | Molex Socket Pin (For All) | 43030-0001 | Molex | Connector | 6-Pin Molex Contacts | Digikey (https://www.digikey.com/product-detail/en/molex-llc/43030-0001/WM1837CT-ND/467810) | 14 | 0.17 | 2.38
 | 9V Battery Contacts | 232 | Keystone | Through-Hole | 9V Battery Contacts | Digikey (https://www.digikey.com/product-detail/en/keystone-electronics/232/36-232-ND/303804) | 1 | 0.60 | 0.60
Case and External Components (Not Part of Board)
 | Red LED | SSI-LXH312ID-150 | Lumex | Panel Mount |  | Digikey (https://www.digikey.com/product-detail/en/lumex-opto-components-inc/SSI-LXH312ID-150/67-1190-ND/145097) | 1 | 1.12 | 1.12
 | DB9 CANBUS Interface | 171-009-103L001 | NorComp Inc. | Panel Mount | Male DB9 | Digikey (https://www.digikey.com/product-detail/en/norcomp-inc/171-009-103L001/209ME-ND/858099) | 1 | 0.81 | 0.81
 | DB9 RS232 Interface | 171-009-202L001 | NorComp Inc. | Panel Mount | Female DB9 | Digikey (https://www.digikey.com/product-detail/en/norcomp-inc/171-009-202L001/209FER-ND/1767044) | 1 | 0.87 | 0.87
 | DB25 Enable Interface | L717SDB25P | Amphenol | Panel Mount | Male DB-25 | Digikey (https://www.digikey.com/product-detail/en/amphenol-commercial-products/L717SDB25P/L717SDB25P-ND/1930965) | 1 | 0.65 | 0.65
 | C13 AC PSU Connection | 716W-X2/01 | Qualtek | Panel Mount | C13 Receptacle | Digikey (https://www.digikey.com/product-detail/en/qualtek/716W-X2-01/Q224-ND/245565) | 1 | 0.81 | 0.81
 | C14 AC Inverter Connection | 701W-X2/02 | Qualtek | Panel Mount | C14 Receptacle | Digikey (https://www.digikey.com/product-detail/en/qualtek/701W-X2-02/Q207-ND/245548) | 1 | 0.78 | 0.78
 | AC Cable for Box to PSU 10' | P004-010 | Tripp Lite | Cable | Box to PSU | Digikey (https://www.digikey.com/product-detail/en/tripp-lite/P004-010/TL441-ND/4429194) | 1 | 8.04 | 8.04
 | AC Cable for Box to Inverter | 11-00022 | Tensility | Cable | Box to Inverter | Digikey (https://www.digikey.com/product-detail/en/tensility-international-corp/11-00022/839-1185-ND/3900584) | 1 | 3.54 | 3.54
 | 9V Wall Wart |  | Coming Data | Cable |  | Amazon (https://smile.amazon.com/Coming-Data-Adapter-Connector-Certified/dp/B0194B7TKO?s=electronics) | 1 | 9.99 | 9.99
 | Barrel Connector 9V Input | PJ-039B | CUI Inc. | Panel Mount | pj-039b | Digikey (https://www.digikey.com/product-detail/en/cui-inc/PJ-039B/CP-039B-ND/1644554) | 1 | 0.69 | 0.69
 | Maintenance LED Connector | 1501761020 | Molex | Panel Mount | Molex Panel Mount | Digikey (https://www.digikey.com/scripts/DkSearch/dksus.dll?Detail&itemSeq=236787863&uq=636392549563717030) | 2 | 0.28 | 0.56
 | Master Kill Switch Connector | 1501761020 | Molex | Panel Mount | Molex Panel Mount | Digikey (https://www.digikey.com/scripts/DkSearch/dksus.dll?Detail&itemSeq=236787863&uq=636392549563717030) | Duplicate
 | Maintenance LED Female Connector | 1501781020 | Molex | Connector | Molex Panel Mount Female | Digikey (https://www.digikey.com/scripts/DkSearch/dksus.dll?Detail&itemSeq=236787889&uq=636392549563717030) | 2 | 0.26 | 0.52
 | Master Kill Switch Female Connector | 1501781020 | Molex | Connector | Molex Panel Mount Female | Digikey (https://www.digikey.com/scripts/DkSearch/dksus.dll?Detail&itemSeq=236787889&uq=636392549563717030) | Duplicate
 | Contacts for Panel Molex Connectors | 1501811016 | Molex | Contacts | Molex Panel Mount Contacts | Digikey (https://www.digikey.com/scripts/DkSearch/dksus.dll?Detail&itemSeq=236788072&uq=636392549563727032) | 4 | 0.10 | 0.40
 | DB25 Cable Standard M/F - 10' | 30-9510MF | Cinch | Cable |  | Digikey (https://www.digikey.com/scripts/DkSearch/dksus.dll?Detail&itemSeq=236792475&uq=636392570802432857) | 1 | 8.07 | 8.07
 | DB9 Cable Standard M/F - 6' | AK129-2 | Assmann | Cable |  | Digikey (https://www.digikey.com/product-detail/en/assmann-wsw-components/AK129-2/AE9869-ND/821624) | 1 | 3.03 | 3.03
 |  |  |  |  |  |  | Total Cost |  | 111.88
