dmitchellspace/bad-habips/PCB/Rev 1/DAQCS_Rev1.pdf

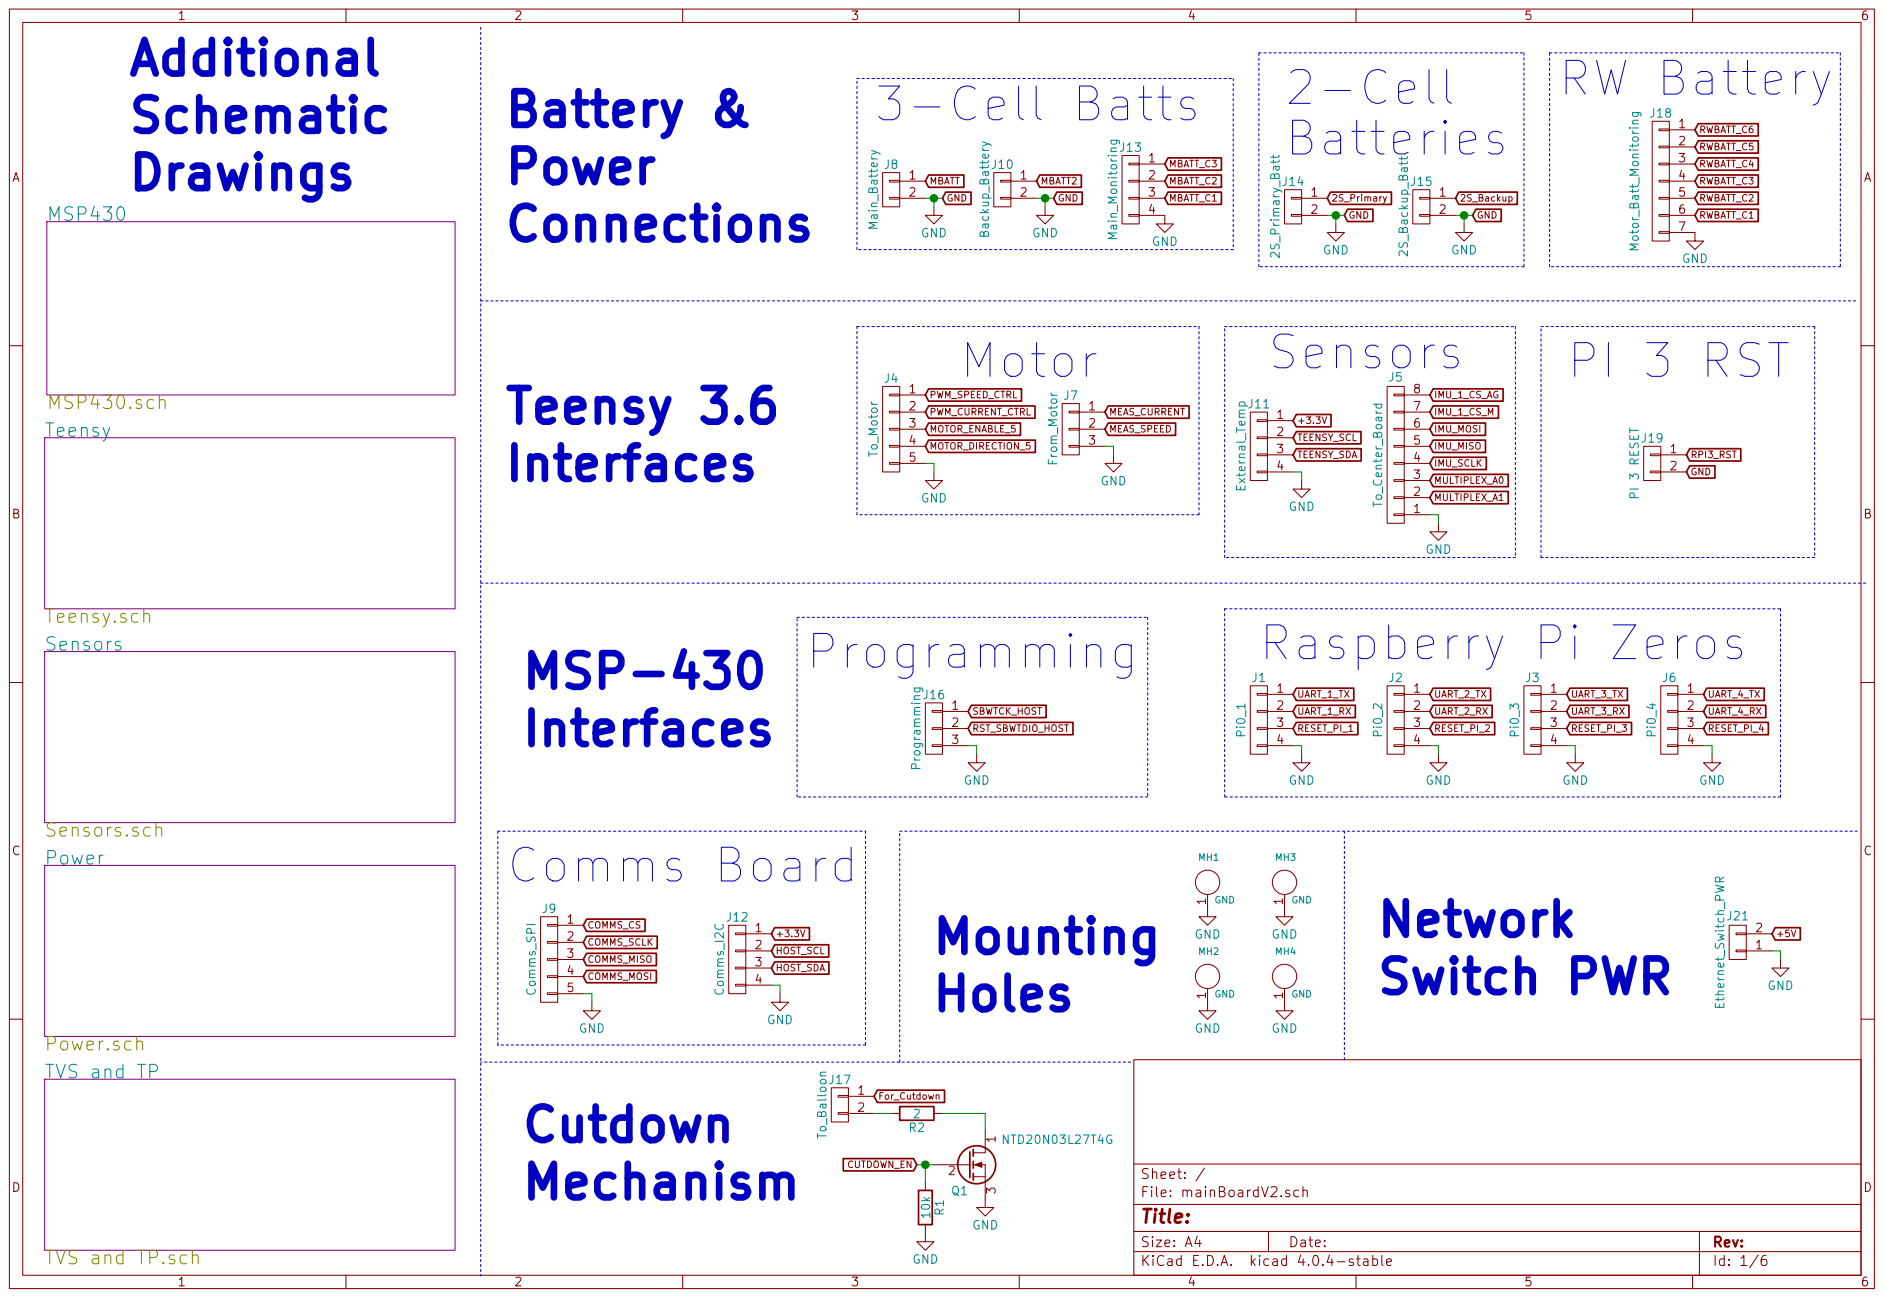
[picture p12: page 1]

Id: 1/6 Title: File: mainBoardV2.sch Sheet: /

TVS and TP.sch

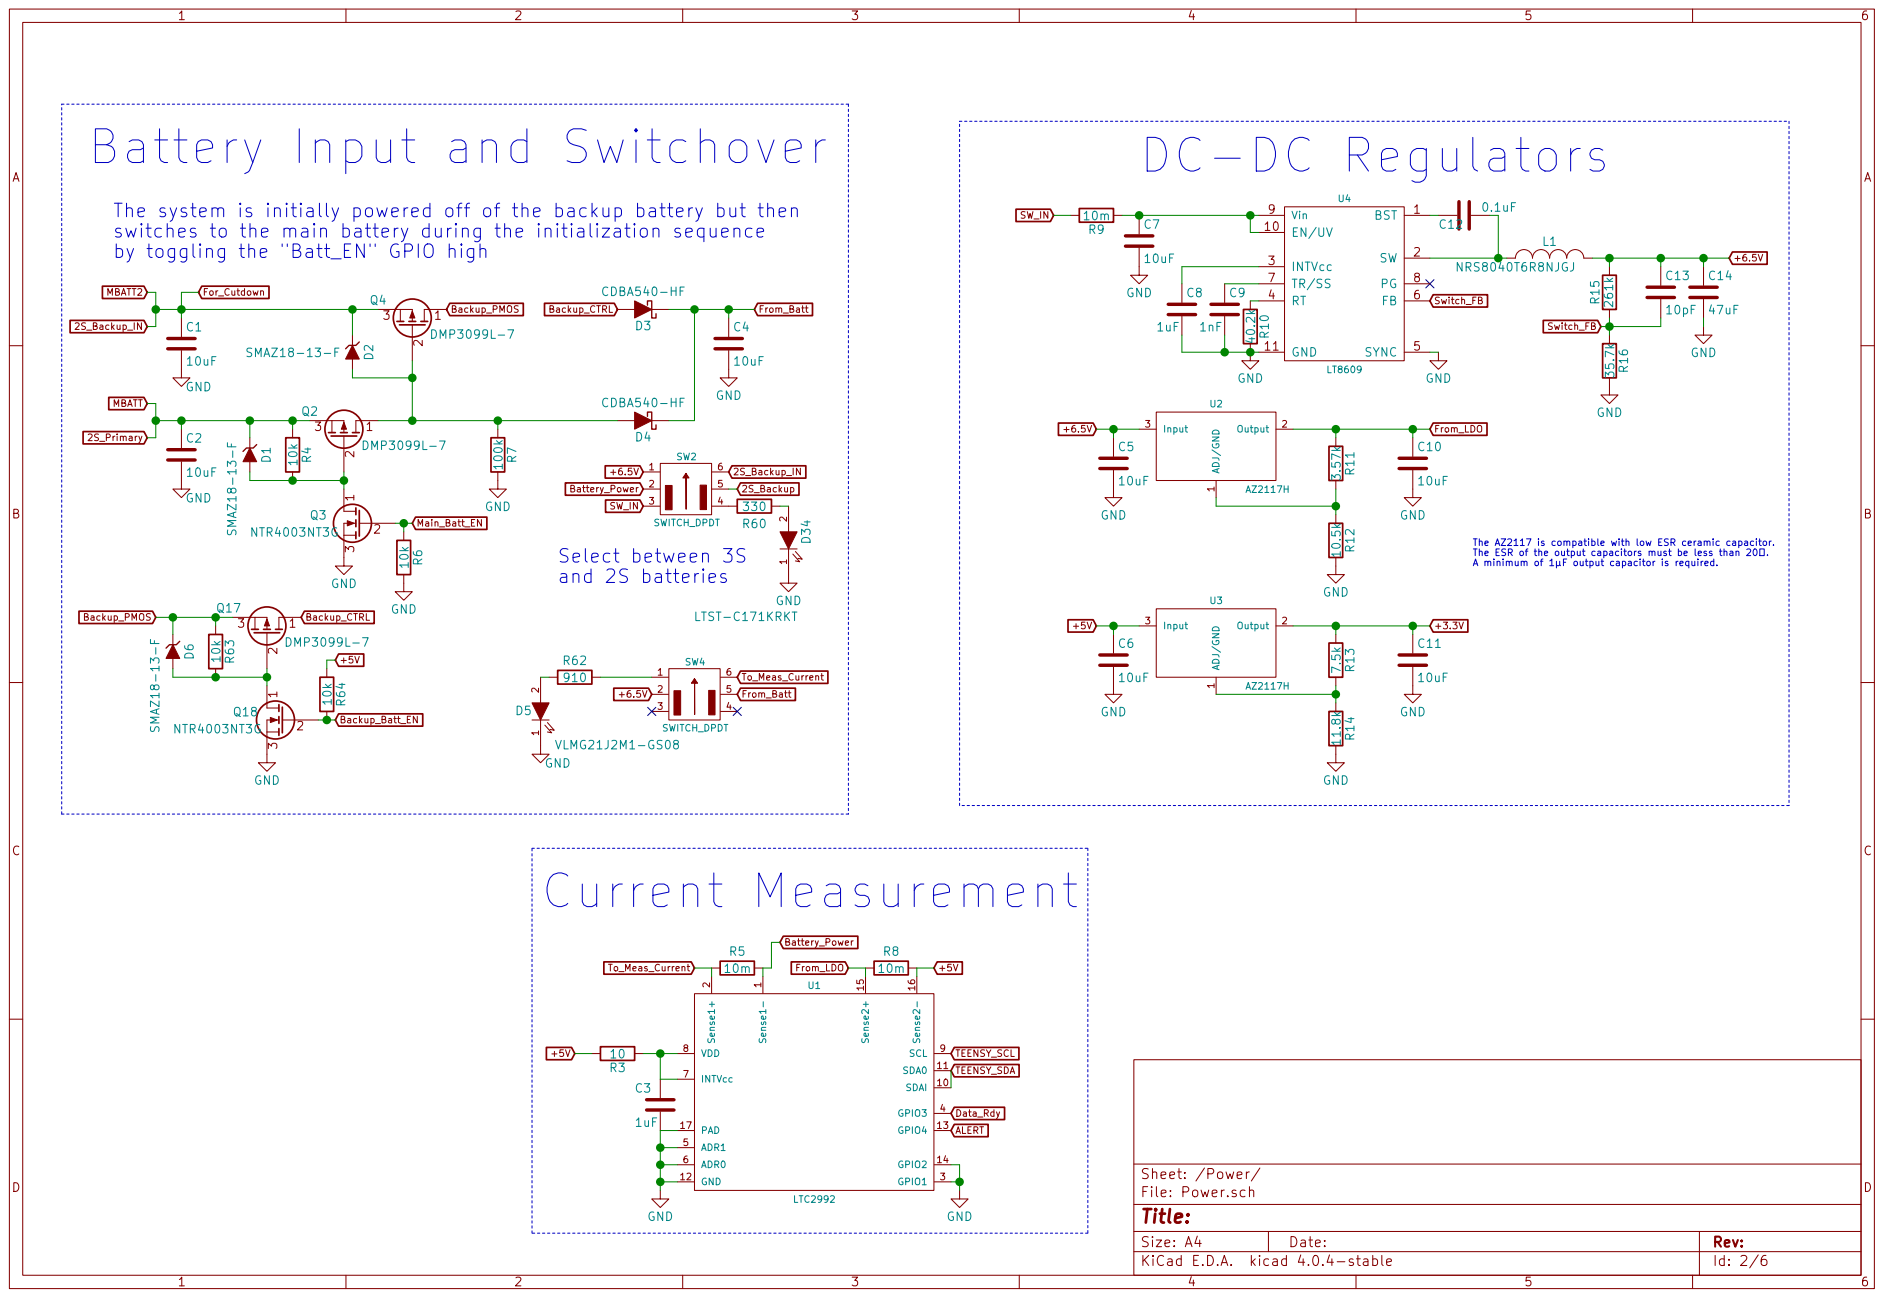
[picture p13: page 2]

Main_Batt_EN The system is initially powered off of the backup battery but then
switches to the main battery during the initialization sequence
by toggling the "Batt_EN" GPIO high

10uF GND GND 7.5k R13 R14 11.8k GND R11 3.57k R12 10.5k GND

Id: 2/6 Title: File: Power.sch Sheet: /Power/

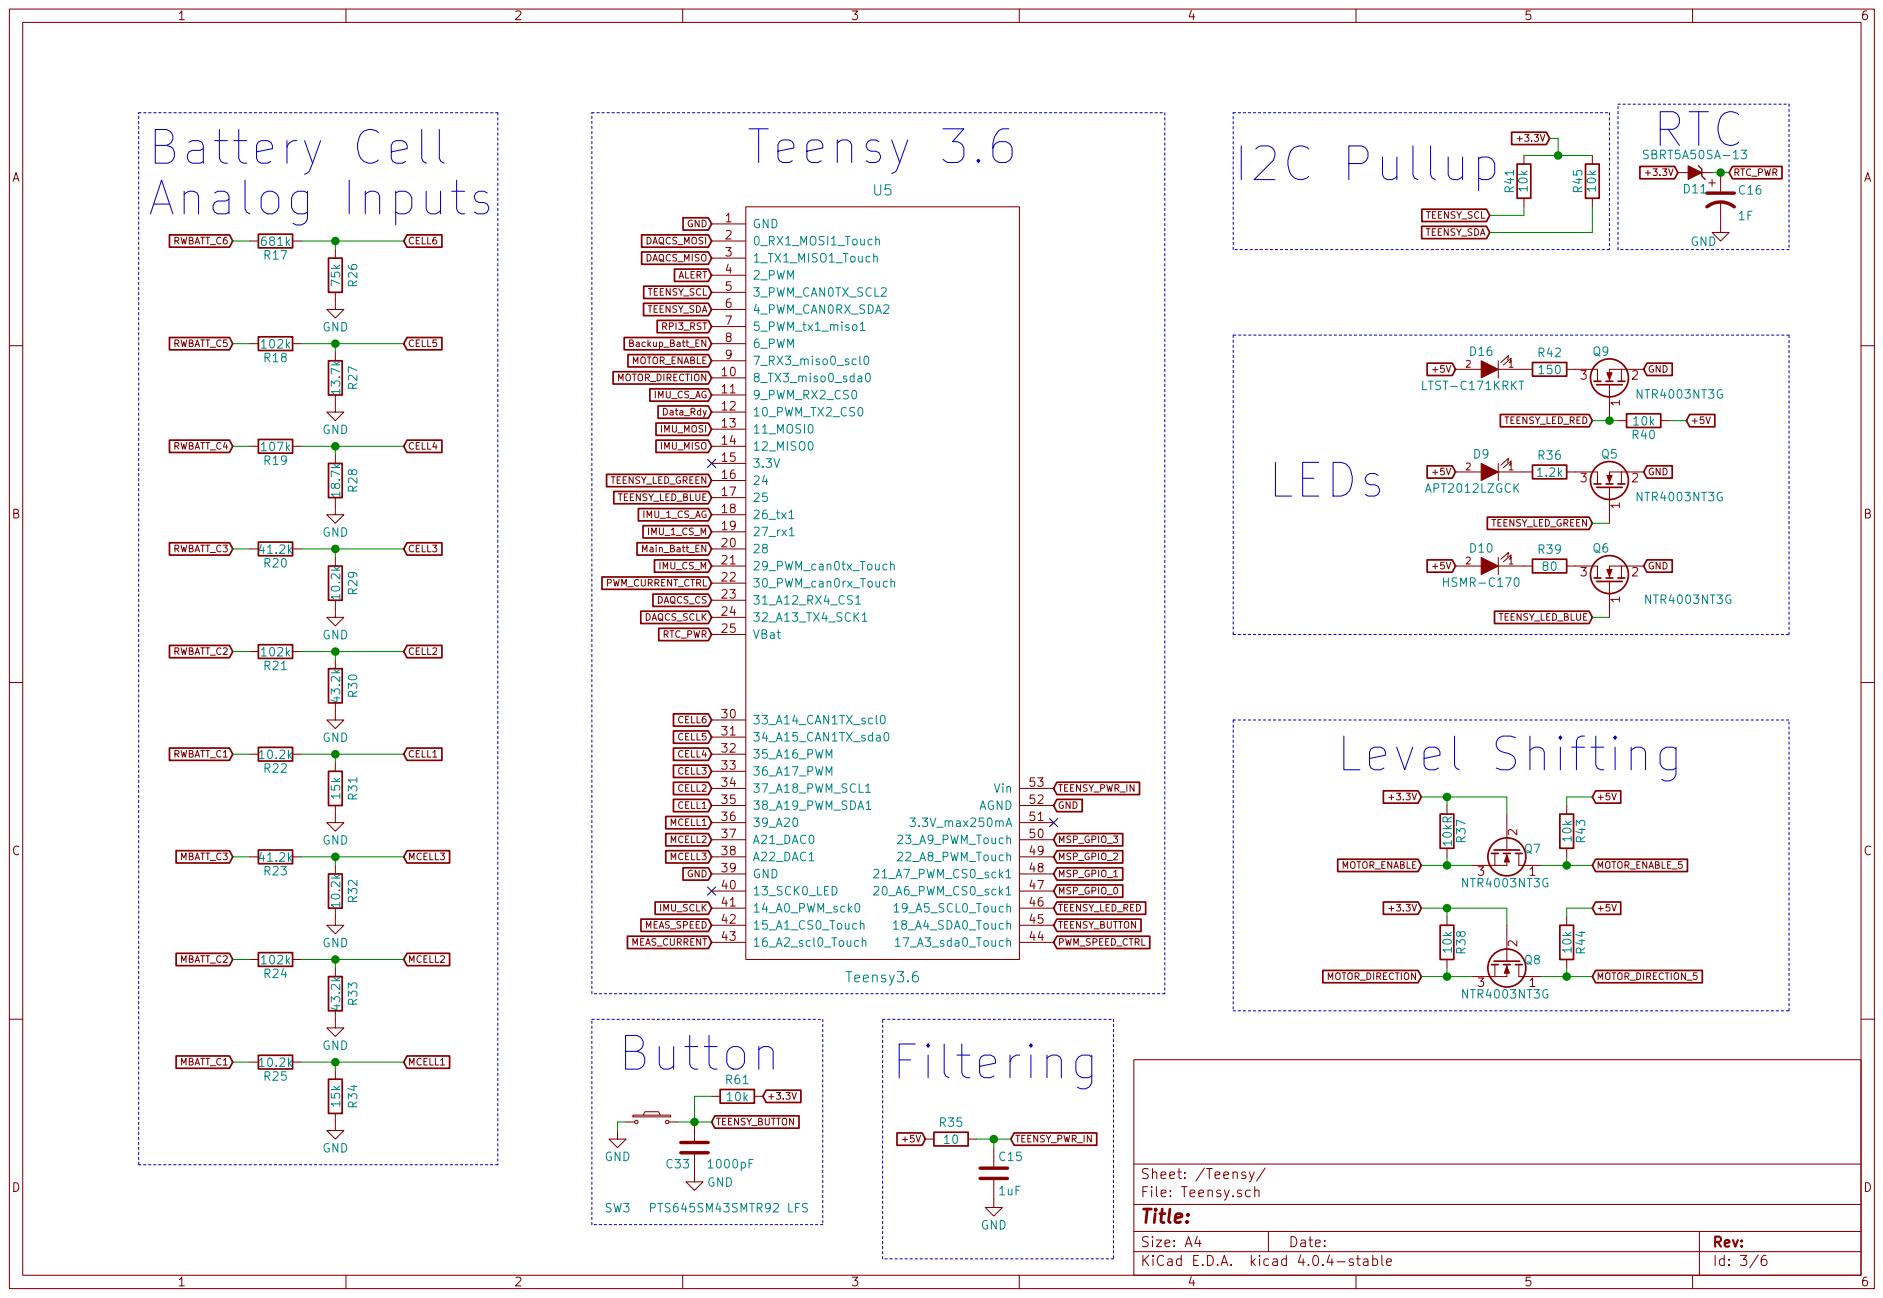
[picture p14: page 3]

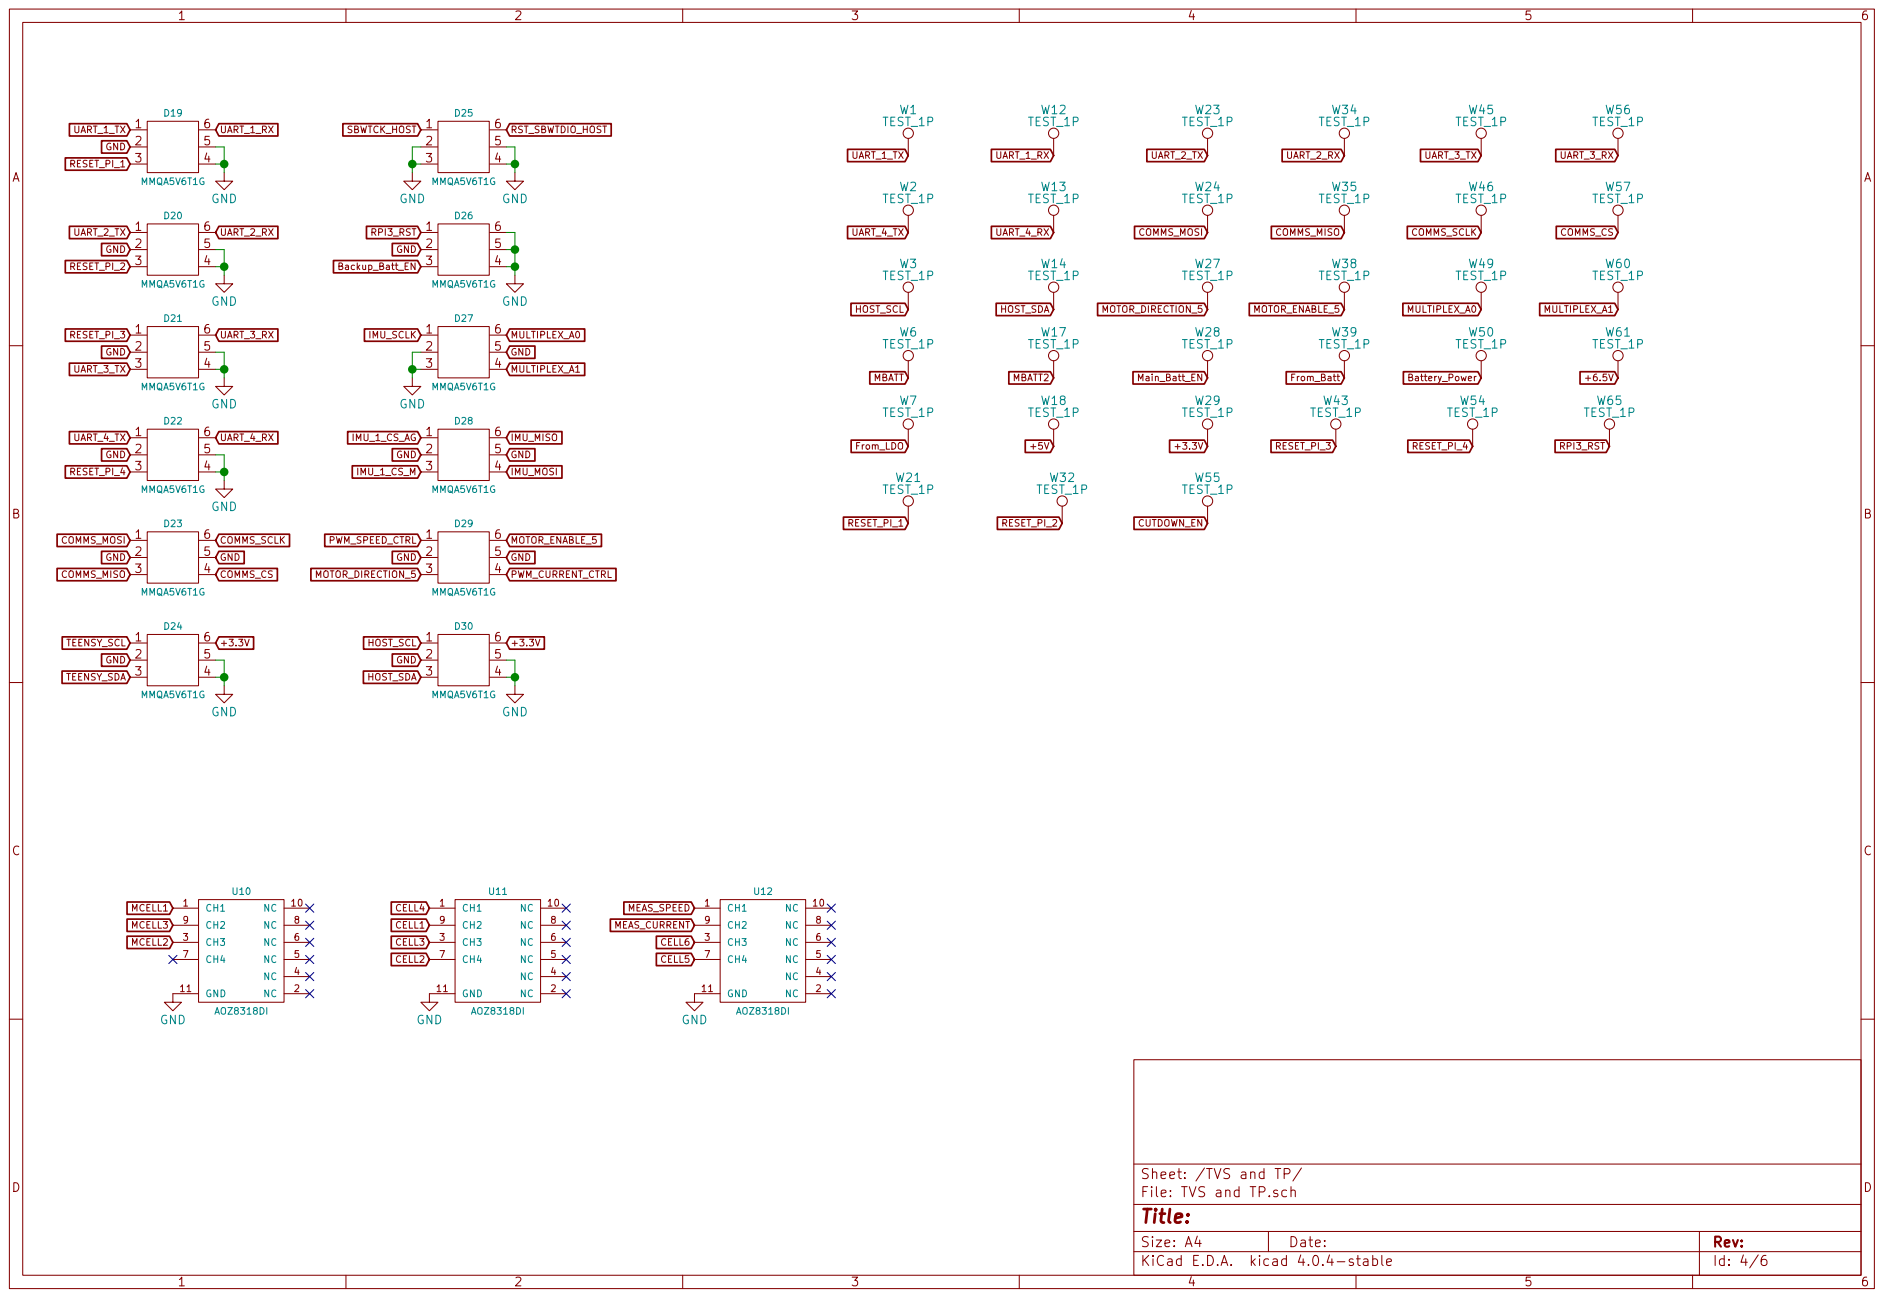
[picture p15: page 4]

Id: 4/6 Title: File: TVS and TP.sch Sheet: /TVS and TP/

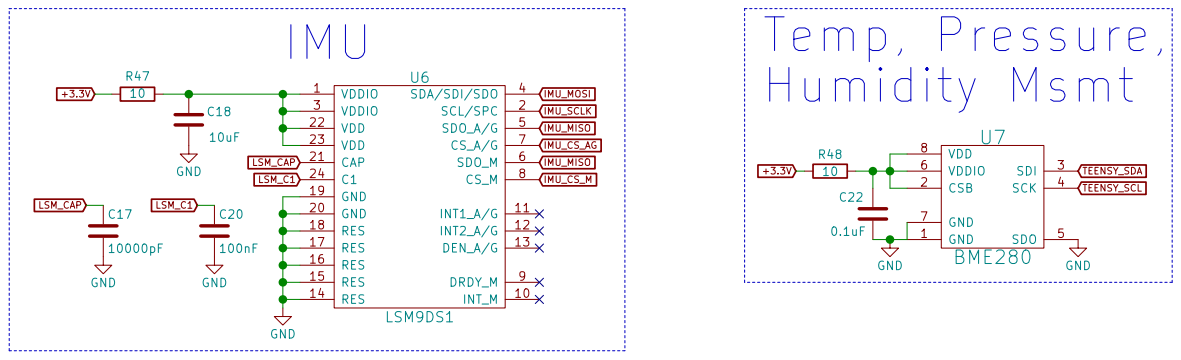
[picture p16: page 5]

Id: 5/6 Title: File: Sensors.sch Sheet: /Sensors/

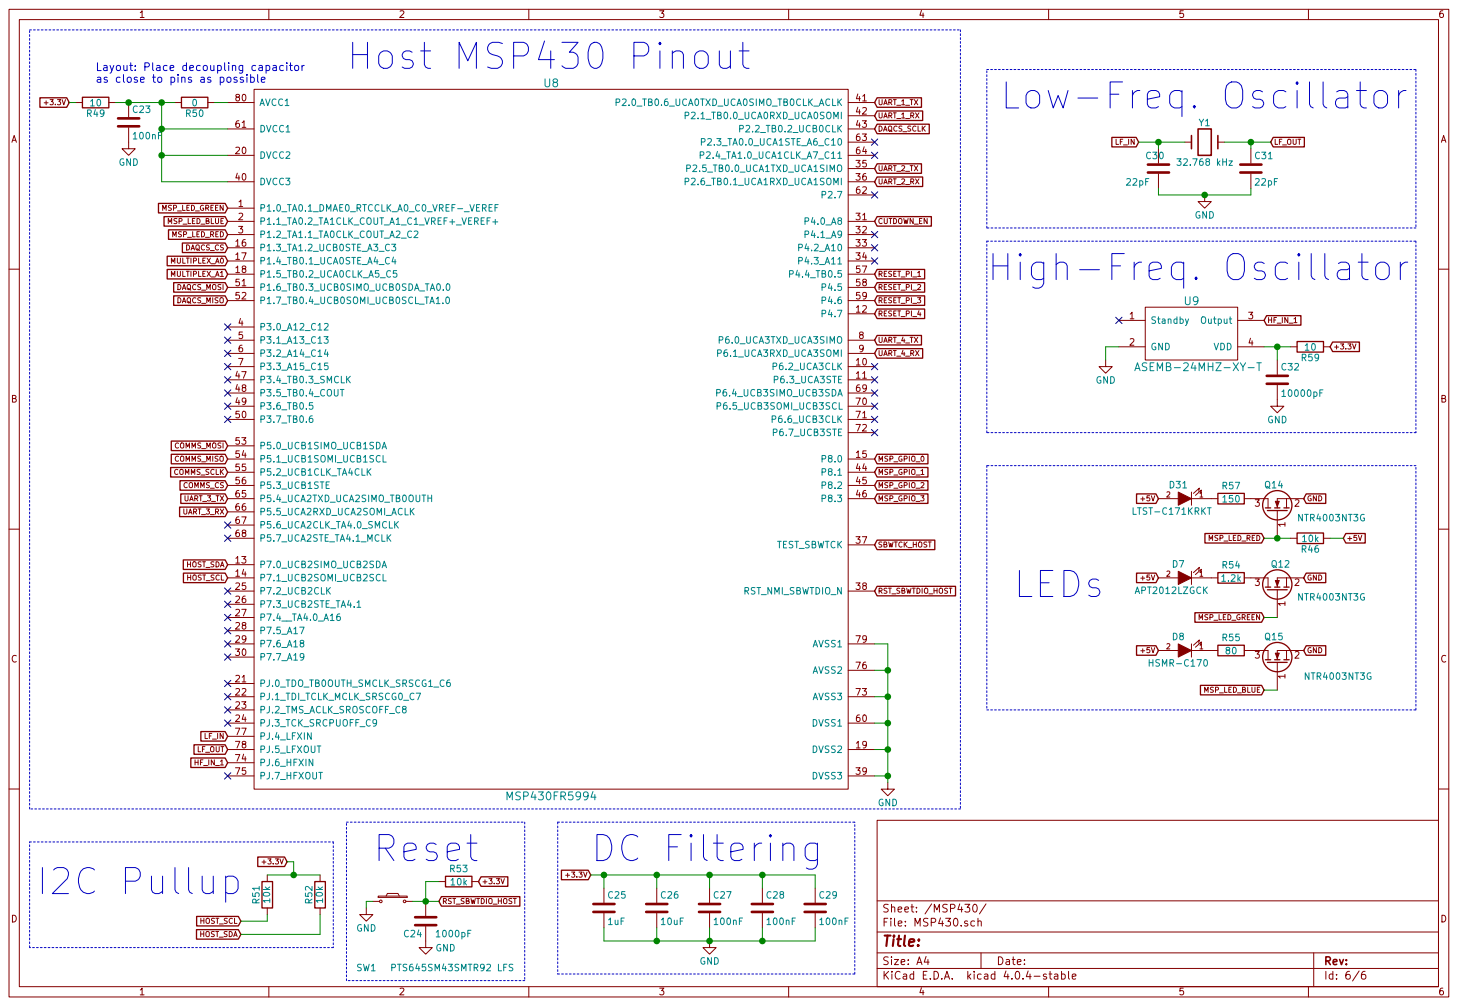
[picture p17: page 6]

Layout: Place decoupling capacitor
as close to pins as possible
0 MSP_LED_GREEN MSP_LED_BLUE COMMS_MOSI COMMS_MISO

Id: 6/6 Title: File: MSP430.sch Sheet: /MSP430/
