dmitchellspace/bad-habips/PCB/Rev 2/Simulations/Switching Regulator Simulation.asc

C1: cap; 1n
C2: cap; 1µ
C3: cap; 0.1µ
C4: cap; 47µ; V=6.3 Irms=0 Rser=0.002 Lser=0 Rpar=1000 Cpar=5p mfg="TDK" pn="C4532X5ROJ47@M" type="X5R"
C5: cap; 10p
C6: cap; 10µ; V=50
L1: ind; 6.8µ; Ipk=3.7 Rser=0.02135 Rpar=207.24 Cpar=0
R1: res; 40.2k
R2: res; 261k
R3: res; 35.7k
Rload: res; 32.5
U1: LT8609
V1: voltage; 12.6
Named nets: 0, OUT, IN
.tran 3m startup
LT8609 - 42V, 2A Synchronous Step-Down Regulator with 2.5µA Quiescent Current
5V, 2MHz, µPower Step Down
Input: 5.5V to 40V       Output: 5V @ 2A, Fsw = 2MHz
Note:
  If the simulation model is not found please update with the "Sync Release" command from the "Tools" menu.
  It remains the customer's responsibility to verify proper and reliable operation in the actual application.
  Component substitution and printed circuit board layout may significantly affect circuit performance or reliability.
  Contact your local sales representative for assistance. This circuit is distributed to customers only for use with LTC parts.
  Copyright © 2015 Linear Technology Inc. All rights reserved.
(1MHz)
