dmitchellspace/bad-habips/PCB/CenterBoard/CenterBoard.kicad_pcb

## KiCad design PCB/CenterBoard/CenterBoard.kicad_pcb (2018-03-20)

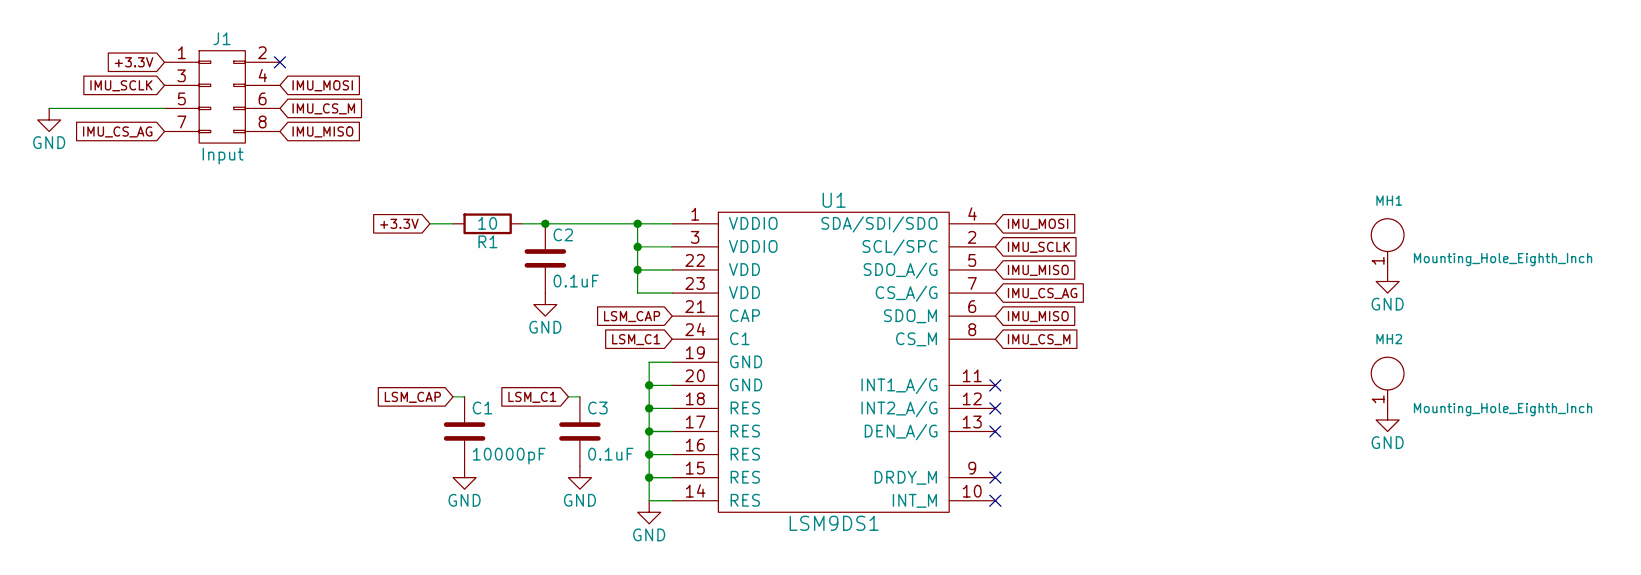
[picture p19: schematic CenterBoard.sch]

Parts:
C1: 10000pF; C_0805_HandSoldering
C2, C3: 0.1uF; C_0805_HandSoldering
J1: Input; CONN_8Pin_Molex_Horizontal_SMT
MH1, MH2: Mounting_Hole_Eighth_Inch
R1: 10; C_0805_HandSoldering
U1: LSM9DS1; PQFN24P43_350X300X102L35X23N

Connections:
+3.3V: J1.1, R1.2
GND: C1.2, C2.2, C3.2, J1.5, MH1.1, MH2.1, U1.14 (RES), U1.15 (RES), U1.16 (RES), U1.17 (RES), U1.18 (RES), U1.19 (GND), U1.20 (GND)
IMU_CS_AG: J1.7, U1.7 (CS_A/G)
IMU_CS_M: J1.6, U1.8 (CS_M)
IMU_MISO: J1.8, U1.5 (SDO_A/G), U1.6 (SDO_M)
IMU_MOSI: J1.4, U1.4 (SDA/SDI/SDO)
IMU_SCLK: J1.3, U1.2 (SCL/SPC)
LSM_C1: C3.1, U1.24 (C1)
LSM_CAP: C1.1, U1.21 (CAP)
unnamed: C2.1, R1.1, U1.1 (VDDIO), U1.3 (VDDIO), U1.22 (VDD), U1.23 (VDD)

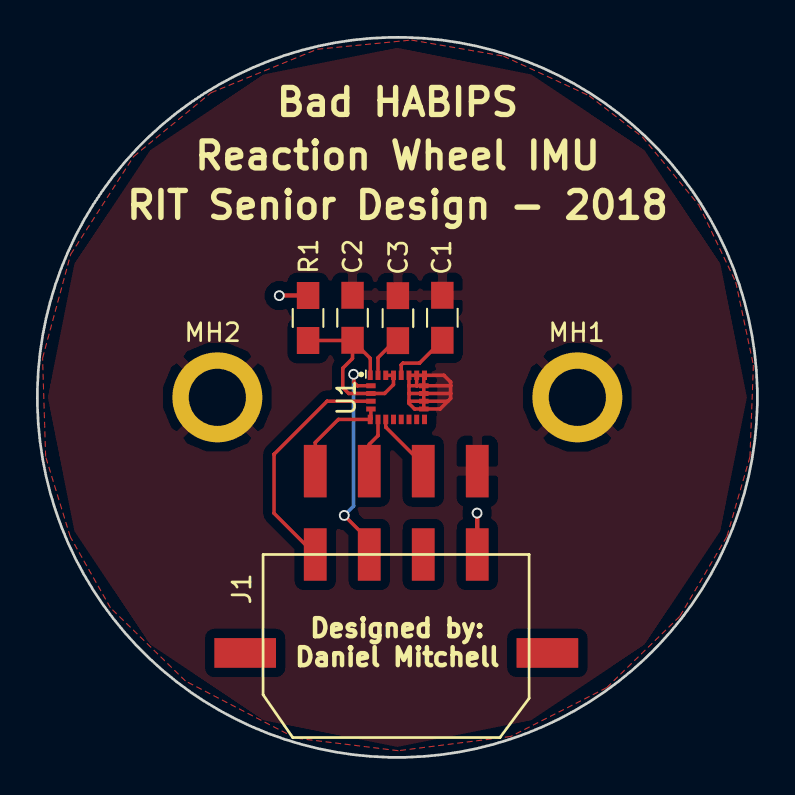
[picture p20: board CenterBoard.kicad_pcb from above]

Board: 2 copper layers, 40.0 x 40.0 mm, 8 parts (0 on the bottom side), 10 nets.
