dmitchellspace/bad-habips/(commit log)

2017-11-15 Teensy 3.6 Psuedo Code
    Original Psuedo Code for Teensy was added, and new folder directory was created.
2017-11-20 Updates to Teensy Code
    1. Teensy folder restructured.
    2. File Structure Set Up.
    3. Psuedo Code put in.
    4. Initliazation of GPIO.
    5. On board LED, as well as blue LED on PCB are toggled to act as a heartbeat.
2017-11-22 Update to Initilization Code
    The following functionality was added:
    1) RTC Initilized. Set to the current date (needs to be manually entered) and the hour minutes and seconds are all intialized to 0.
    2) SD Card Initilization. The interface with the card is initilized and a file is created on the card called HABIP.txt. This file is given a header that contains the date.
    3) A simple Self Test is run on the RTC as well as the SD card. The RTC ST is making sure the clock got set to the desired time. The SD Card Self Test is to make sure that the created file can be accessed.
    4) If the SD card does not initilize it will be retried. If the reaction wheel is not enabled, the only function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
2017-12-01 Updates to Initialization Code
    LED is blinked three times quickly to show user SD card is not working.
    I2C Initiliazation is setup. Verified correct address and R/W commands were being TXd. Without any of the components we cannot verify it is working, because we don't get an
    acknowledge byte back.
    A RX interrupt still needs to be setup.
    Pins for motor control are setup.
    PWM is setup and verified.
    PWM signal will be running at 1kHz as opposed to 50 Hz from last semester.
    [Clocks.cpp, Clocks.h, I2C.cpp, I2C.h, MotorControl.cpp, MotorControl.h, SPI.cpp, TeensyMotorControl.ino]
2017-12-06 Updates to initialization code
    ADC Initialization was implemented and successfully tested.
    A calibration of the unit is performed and the Successfull/Not Successful is determined based off of the cal results.
    The ISR has not yet been integrated.
    Frequency of PWM signal was changed to 75Hz. This allows for more varience in the PW.
    SPI has been initialized. Nothing has been tested yet, this still needs to be done. Interrupts need to be set up.
2018-01-23 SPI Bus to IMU Working
    ADC Interrupt Setup
    SPI transmitting to IMU verified.
    Self Test added where SPI will write to IMU "WHO_AM_I" register. If the correct response is heard back, it will mark it as a pass.
    Right now requests are being made for the IMU data, but nothing is being recorded.
    The IMU read function is set up to read from either of the two chips. The chip select is an input to the function.
    The IMU that we currently have was wired as an IMU0 and then as an IMU1. It was verified that we are able to talk to it in either configuration.
    [MotorControl.cpp, SPI.cpp, SPI.h, TeensyMotorControl.ino]
2018-01-26 IMU SPI Updates
    Added timeout on SPI transactions. 1ms timeout
    Right now I'm setting a flag that says a timeout happened, but not actually doing anything with that flag. This functionality needs to be added.
    Added Data Write function for SPI0
    Data coming back from the IMU is not being handled right now. Matt C. is going to look into how the data needs to be handled. This will probably be a couple versions from now.
    It is verified that everything on the IMU is being enabled and that the data coming back changes once the IMU is moved around.
2018-01-29 Updates to SD Card Logging, RTC logging
    Version 7:
    Added function to get the current time from the RTC. It populates an array as [sec, min, hr, day, month, year]
    Added Data Write function to the SD Card
    Added New line write function to the data card.
    Right now I have it working where it prints all of the data on one line with one timestamp for all 6 IMU data pieces.
    Each set of 6 reads/write takes approximately 60ms, so one time stamp is fine for this.
    Add timer to trigger an interrupt every second. This says that its time to get the pressure and temp functions. Inside this loop the Heartbeat function is called which flashes the LED.
2018-01-31 Updates to SD Card, SPI0 bus, and IMU
    Made DataNotValid a global variable so that it can be checked anywhere.
    Made SD Card file comma seperated
    Added IMU Select. If IMU0 passes initialization it will gather data from that. If it fails initialization it will gather data from IMU1.
    Added check for SPI0 timeout. It will print an error message on the SD card as well as reinitialize the SPI bus.
    Added Twos Compliment calculation for all the IMU data. With the two's compliment done, the reads/writes take 20ms.
    Change file type on SD Card to .csv
    [SDCard.cpp, SDCard.h, SPI.cpp, SPI.h, TeensyMotorControl.ino]
2018-02-04 Components Placed - Needs Routing and TPs
    [MSP430.sch, Mux and TVS.sch, Power.sch, Sensors.sch, TVS and TP.sch, Teensy.sch, Video Multiplexing.sch, mainBoardV2.kicad_pcb]
2018-02-07 Integrated Motor Algorithim
    Added functions to turn motor on/off
    Started reaction wheel algorithim. Only going to do LSB conversions for Z-Gyro when the reaction wheel is running. Otherwise its using recources that we don't need to use. Data is captured and then converted to rev/min.
    Took out the two's compliment function. Now when the data comes back from the IMU it's being placed into a 16 bit short instead of a 32 bit int. Because it's in the 16 bit short the compiler recognizes it as a negative number, which makes no need for two's compliment.
    A button will be used in order to determine if a calibration of the IMU is to be done. This button needs to be held down on startup in order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
    [GPIO.cpp, MotorControl.cpp, MotorControl.h, SDCard.cpp, SDCard.h, SPI.cpp, TeensyMotorControl.ino]
2018-02-10 Updates to SD Card logging when motor is on
    In order to make the motor controller algorithim run as efficiently as possible, the manner in which SD card writes is done is going to be chagned (only for while the motor is on). The opening and closing of the file structure is what takes the longest amount of time, and therefor this will only be done when neccessary. The reason that closing it takes a while is because it clears the buffer on a close. The buffer is 512 characters long and so it is not neccessary to do this every time.
    As a result the file will be opened once upon entering the loop, closed once upon leaving the loop, and the buffer will be cleared after all six of the IMU write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
2018-02-10 Layout Done - Needs TPs Still
    [MSP430.sch, Power.sch, Sensors.sch, TVS and TP.sch, Teensy.sch, mainBoardV2.kicad_pcb, mainBoardV2.sch]
2018-02-12 Board Completed. Needs Review
    [MSP430.sch, Power.sch, Sensors.sch, TVS and TP.sch, Teensy.sch, mainBoardV2.kicad_pcb, mainBoardV2.sch]
2018-02-13 Updated a couple nets to the proper voltage and re-plotted the schematic
    [mainBoardV2.kicad_pcb, mainBoardV2.sch]
2018-02-15 I2C Functionality Added
    Uploaded on 02/15/2018
    Added initialization for I2C
    Added Write Function for I2C
    Added Read Function for I2C
    The come up for the sensor is the following process:
    1) Initialize pins
    2) Read ID register, and mark sensor as pass/fail
    3) If pass write to config registers
    This functionality has been tested and confirmed.
    [Clocks.cpp, I2C.cpp, I2C.h, TeensyMotorControl.ino]
2018-02-16 Temperature/Pressure Sensor Read/Write
    Added temp/pressure read every second
    Added temperature calibration data read on startup
    Added pressure calibration read on startup
    The writes to the SD card were added.
    The writes for temperature and pressure sensors take a really long time due to their size. As a result the motor on method is used in order to keep it in a reasonable time window. The card is opened once, both values are written, and then the SD card is closed.
    Read/Write are also added for when motor is on.
2018-02-21 Added BOM, Couple Fixes, Couple Misc Documents
    [MSP430.sch, MainBoardV2_BOM.xlsx, Sensors.sch, TVS and TP.sch, Teensy.sch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]
2018-02-21 ADC Working
    A loop was added so that the motor algorithim is run 8 times in between reads and writes. This includes a 10ms delay. This delay can be taken back out if other functionality needs to be added. This keeps it so that the IMU is only being written to the SD card once every 70ms, which is the desired time. This will make the motor more precise.
    In order to read from all nine battery cells both ADC modules will be used. The initialization was added to intialize both of them. The isr was set up for the second ADC module, and a switch statement is used in both of the isrs. This is used so that this can be run in the background while other data is being processed.
    Added SD Card w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
2018-02-23 Multiple SD Card Files
    A series of SD card files were added. Because they need to be of type const char* they were hardcoded in an array. It is set up so that a new file can be added every 5 minutes for 4 hours. After it adds the last file it will just continue to write to this file.
    The file number that we are on is written to non-volitiale memory. This is done so that if we lose power we don't overwrite the data that is already written
    The RTC is checked on startup to see if it is already initialized. This is done in case the teensy loses power but the RTC does not. If this is the case the old RTC values are used.
2018-02-23 Added Teensy Spreadsheet
    A spreadsheet was added that is used to decode the data that is coming back from the Teensy. If the data is copied and pasted from the SD card into this spreadsheet it will automatically calculate everything into the units that we want
    [DecodeData.xlsm]
2018-02-27 Current Sensor Added, Miscellaneous Updates
    Added a check where the user can press the button in order to restart the file system. If the button is pressed before the LED starts to flash the calibration on the IMU will be performed. If the button is pressed in the ~4second window while the LED is flashing rapidly the file system will restart at number 0. Anytime after this window the button will not do anything.
    The file names were shortened from HABIP#.csv to H#. This was done in order to save on RAM.
    Added a function to display the results of the Self test on the LEDs. A boolean array was added to store the results. The array is formatted as follows:
    [Current Sensor, ADC0, ADC1, DAQCS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
    [DecodeData.xlsm]
2018-03-13 Added SPI to MSP430
    Added SPI Interface with the MSP430.
    Messages are parsed and data is formatted to be sent out. Everything is done inside the ISR, because a request from the MSP430 can come at any point in time.
    This was tested using a test bench constructed in a seperate Visual Studio file. The MSP430 code has not yet been written, and so this was the only method to test.
    The functionality of the algorithim was verified, but the functonality of the SPI slave configuration cannot be verified until the MSP430 code has been written.
2018-03-20 Some main board fixes, added center board, developing MSP430 code
    [CenterBoard-B.Cu.gbr, CenterBoard-B.Mask.gbr, CenterBoard-B.SilkS.gbr, CenterBoard-Edge.Cuts.gbr, CenterBoard-F.Cu.gbr, CenterBoard-F.Mask.gbr, CenterBoard-F.SilkS.gbr, CenterBoard.drl]
2018-03-21 Miscellanious Updates found in Testing and Integration
    Changed the way SD files are named. const_cast<char*> is now used to convert from a char* to a const char*, that way the file name can be created on the fly.
    The new format of file names are hhmmss.csv. This works as a timestamp
    According to the schematic the addresss should be 6F because both pins should be grounded. It seems like one of the pins is actually not connected, and so the address is actually 0x6E. If the pin is properly grounded the address should be changed back to 0x6F.
    Updated so that IMU1 is the default IMU (the one that's centered around the motor) and if it fails then IMU0 is used.
    A retry was added on the calibrat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
    [DecodeData.xlsm]
2018-03-27 SPI with DAQCS Board
    A derivative was added to the controller, making it a PID instead of a PI. The values are now kp = 120, ki = 0.2, kd = 0.01. Testing with the current setup (Two PCBs the arduino board, the motor controller, motor and three batteries mounted to the chassis) has shown to be good. The numbers might need to be adjusted again once everything is connected.
    A delay was added after the write to the motor of 50ms. It was found that writing too fast caused problems. We were writing at a rate significantly faster than the mechanical time constant, and this was giving issues. Now with this delay everything seems happy.
    The SPI is added but IT IS NOT WORKING. The algorithim an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
    [GPIO.cpp, GPIO.h, I2C.cpp, I2C.h, SDCard.cpp, SDCard.h, SPI.cpp, TeensyMotorControl.ino]
2018-04-04 Updates for Launch
    Some of the launch day patches were added. This includes using the altitude to check for 40,000 feet and 10,000 feet. It triggers a cutdown at three hours and 40,000 feet. The motor turns on at either 10,000 feet or ten minutes. The timer for these two start once we are past two hundred feet from the ground. the two hundred foot measurement is the only relative measurment. The other two are taken from sea level. The original time is stored in flash memory. It is reset when the button is held on startup.
    There is a problem with the RTC losing power. We thought using a super cap would be enough to keep it going, but that doesn't seem to be enough. As a result I am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
    [Clocks.cpp, GPIO.cpp, GPIO.h, I2C.cpp, I2C.h, MotorControl.cpp, MotorControl.h, SDCard.cpp]
2018-04-30 Imagine/Launch functionality added
    This functionality is only for imagine, and the patched launch. This should not be neccessary if you are going to have a working comms board.
2018-05-01 Teensy User Guide
    Teensy User Guide was created
2023-10-28 Updated files and organization
    [DAQCS-Rev2.kicad_pcb, DAQCS-Rev2.sch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]
